ratshgupta-guptar76/blueprints/reports/summary.md

# Summary

```r
┏━━━━━━━━━━━━━━━━━━━━━━┳━━━━━━━━━━┳━━━━━━━━━━┳━━━━━━━━━━┳━━━━━━━━━━┳━━━━━━━━━━━┳━━━━━━━━━━┳━━━━━━━━━━━┳━━━━━━━━━━┳━━━━━━━━━━━┳━━━━━━━━━━┳━━━━━━━━━━━┳━━━━━━━━━━┓
┃                      ┃ Hold     ┃ Reg to   ┃          ┃          ┃ of which  ┃ Setup    ┃           ┃          ┃           ┃ of which ┃           ┃          ┃
┃                      ┃ Worst    ┃ Reg      ┃          ┃ Hold Vio ┃ reg to    ┃ Worst    ┃ Reg to    ┃ Setup    ┃ Setup Vio ┃ reg to   ┃ Max Cap   ┃ Max Slew ┃
┃ Corner/Group         ┃ Slack    ┃ Paths    ┃ Hold TNS ┃ Count    ┃ reg       ┃ Slack    ┃ Reg Paths ┃ TNS      ┃ Count     ┃ reg      ┃ Violatio… ┃ Violati… ┃
┡━━━━━━━━━━━━━━━━━━━━━━╇━━━━━━━━━━╇━━━━━━━━━━╇━━━━━━━━━━╇━━━━━━━━━━╇━━━━━━━━━━━╇━━━━━━━━━━╇━━━━━━━━━━━╇━━━━━━━━━━╇━━━━━━━━━━━╇━━━━━━━━━━╇━━━━━━━━━━━╇━━━━━━━━━━┩
│ Overall              │ 0.3302   │ 0.3302   │ 0.0000   │ 0        │ 0         │ 22.2979  │ 22.2979   │ 0.0000   │ 0         │ 0        │ 0         │ 0        │
│ nom_tt_025C_3v30     │ 0.4971   │ 0.4971   │ 0.0000   │ 0        │ 0         │ 26.9422  │ 26.9422   │ 0.0000   │ 0         │ 0        │ 0         │ 0        │
│ min_tt_025C_3v30     │ 0.4866   │ 0.4866   │ 0.0000   │ 0        │ 0         │ 27.0217  │ 27.0217   │ 0.0000   │ 0         │ 0        │ 0         │ 0        │
│ max_tt_025C_3v30     │ 0.5097   │ 0.5097   │ 0.0000   │ 0        │ 0         │ 26.8483  │ 26.8483   │ 0.0000   │ 0         │ 0        │ 0         │ 0        │
│ nom_ff_n40C_3v60     │ 0.3384   │ 0.3384   │ 0.0000   │ 0        │ 0         │ 28.7241  │ 29.7522   │ 0.0000   │ 0         │ 0        │ 0         │ 0        │
│ min_ff_n40C_3v60     │ 0.3302   │ 0.3302   │ 0.0000   │ 0        │ 0         │ 28.7914  │ 29.8150   │ 0.0000   │ 0         │ 0        │ 0         │ 0        │
│ max_ff_n40C_3v60     │ 0.3481   │ 0.3481   │ 0.0000   │ 0        │ 0         │ 28.6435  │ 29.6729   │ 0.0000   │ 0         │ 0        │ 0         │ 0        │
│ nom_ss_125C_3v00     │ 0.7416   │ 0.7416   │ 0.0000   │ 0        │ 0         │ 22.4203  │ 22.4203   │ 0.0000   │ 0         │ 0        │ 0         │ 0        │
│ min_ss_125C_3v00     │ 0.7283   │ 0.7283   │ 0.0000   │ 0        │ 0         │ 22.5227  │ 22.5227   │ 0.0000   │ 0         │ 0        │ 0         │ 0        │
│ max_ss_125C_3v00     │ 0.7576   │ 0.7576   │ 0.0000   │ 0        │ 0         │ 22.2979  │ 22.2979   │ 0.0000   │ 0         │ 0        │ 0         │ 0        │
└──────────────────────┴──────────┴──────────┴──────────┴──────────┴───────────┴──────────┴───────────┴──────────┴───────────┴──────────┴───────────┴──────────┘

```
