ratshgupta-guptar76/blueprints/docs/analog_sim/read_disturb_hi_qrbl.png

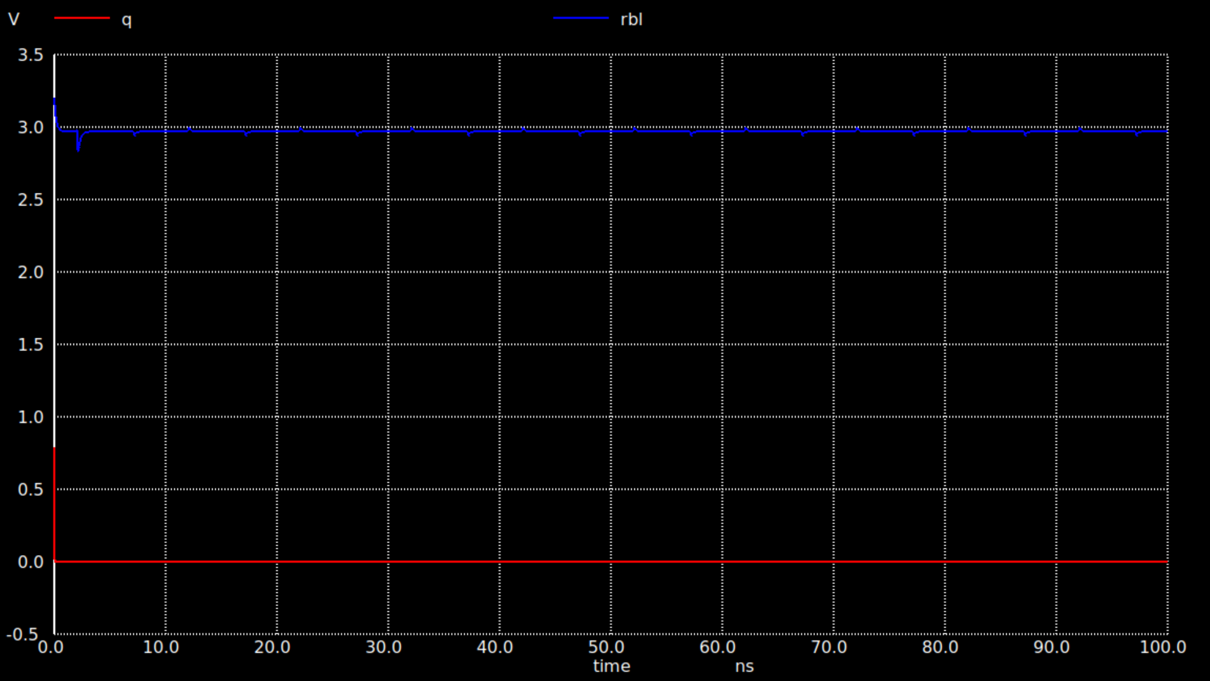
docs/analog_sim/read_disturb_hi_qrbl.png
