ratshgupta-guptar76/blueprints/docs/architecture/8T_03v3.png

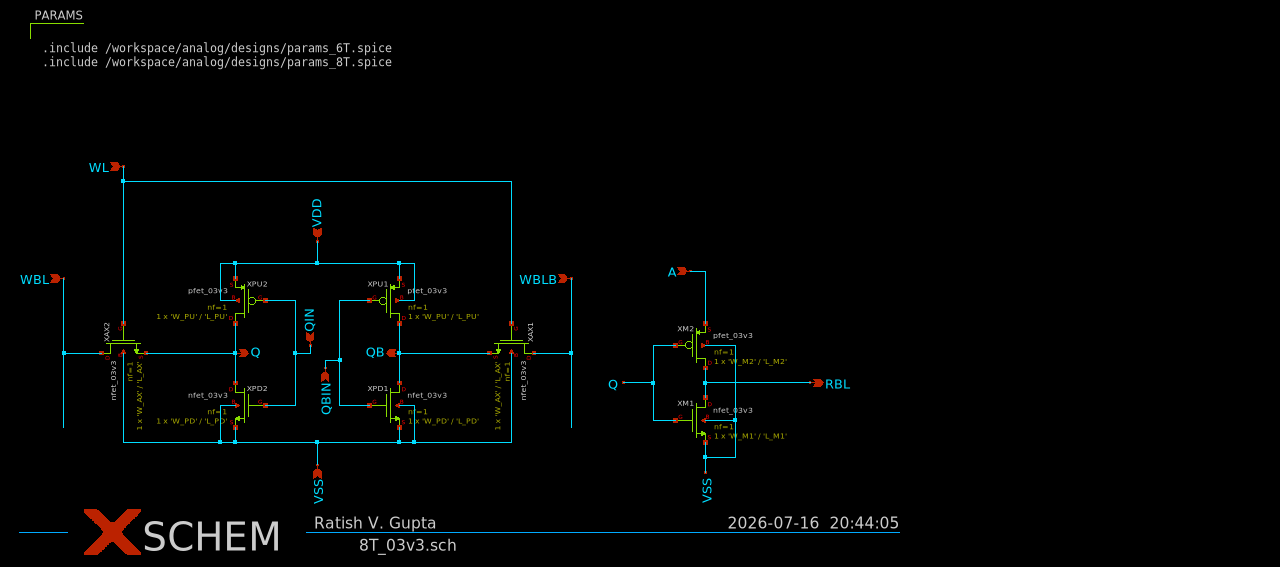
docs/architecture/8T_03v3.png
