ratshgupta-guptar76/blueprints/docs/architecture/ComputeFlow.png

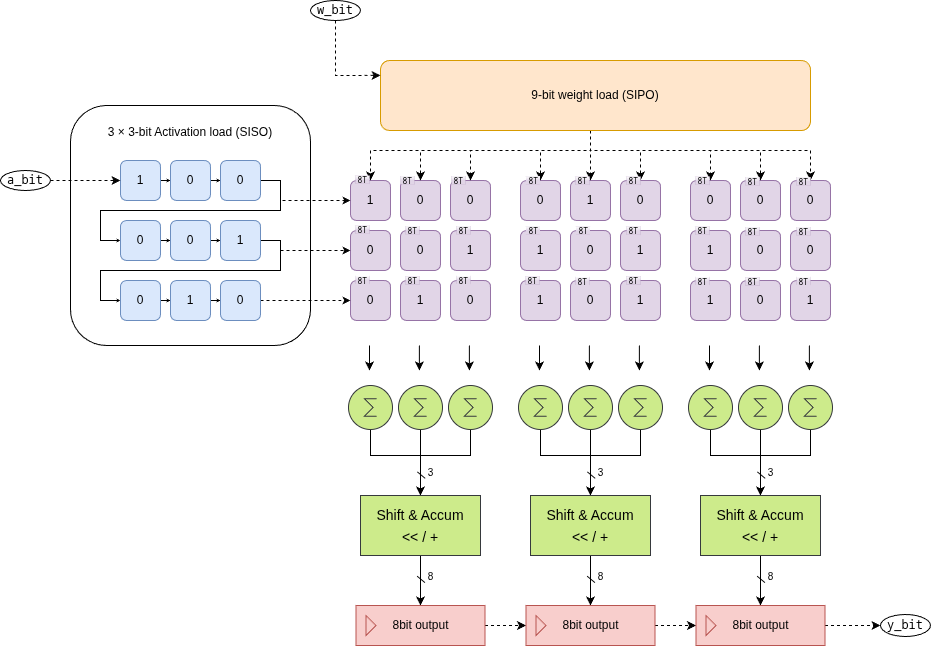
docs/architecture/ComputeFlow.png
