ratshgupta-guptar76/blueprints/docs/architecture/ComputeFlow_edited.png

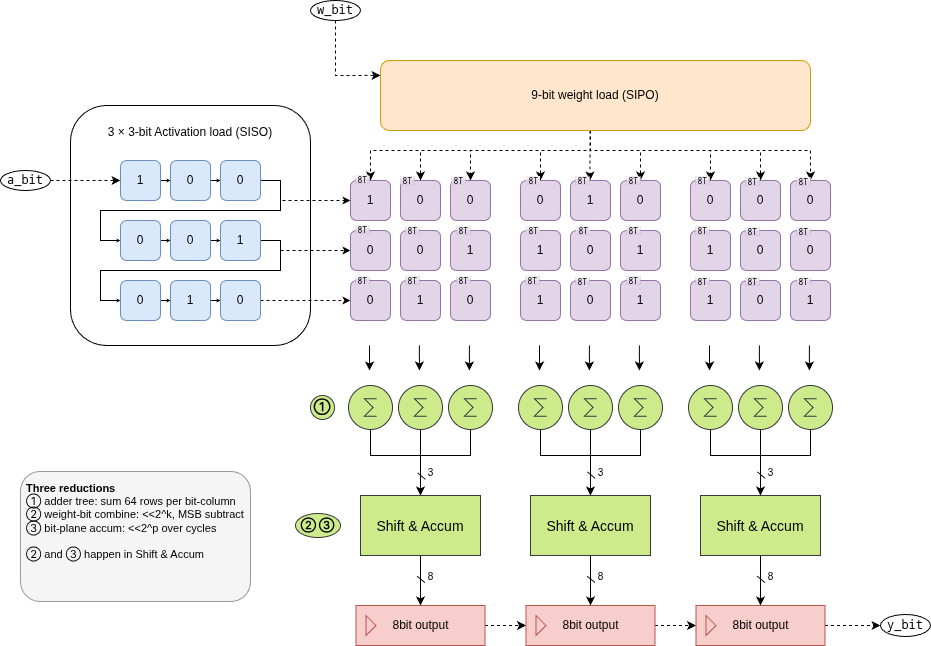
docs/architecture/ComputeFlow_edited.png
