ratshgupta-guptar76/blueprints/docs/architecture/fsm_states.png

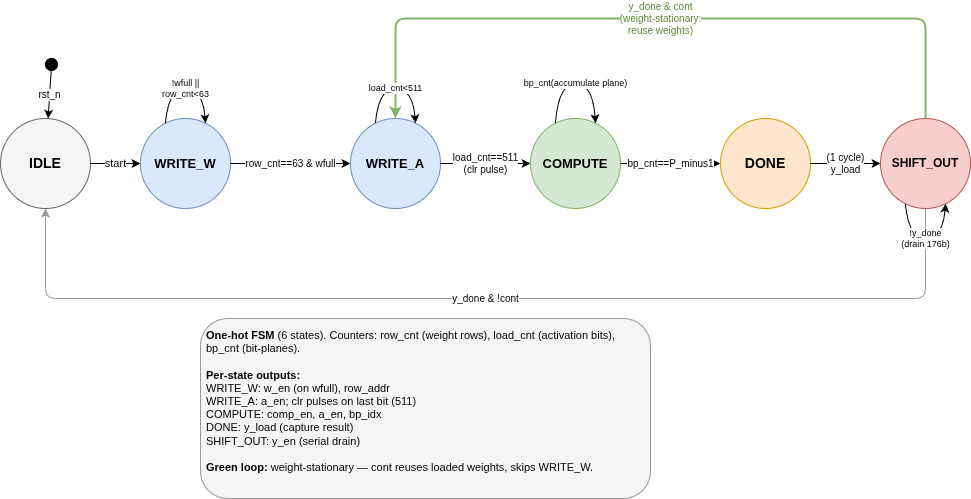
docs/architecture/fsm_states.png
