ratshgupta-guptar76/blueprints/docs/architecture/System_overview.png

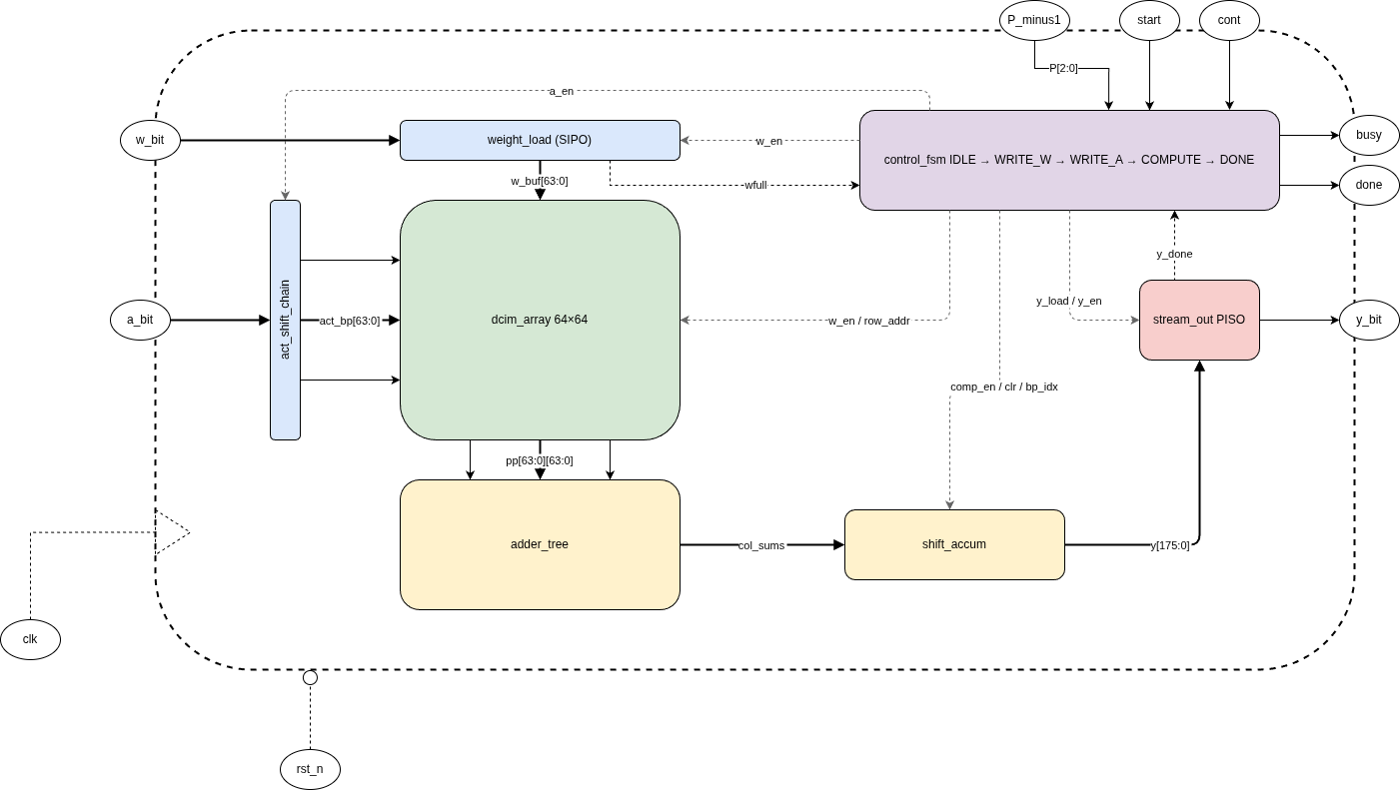
docs/architecture/System_overview.png
