ratshgupta-guptar76/blueprints/docs/architecture/SystemOverview2.png

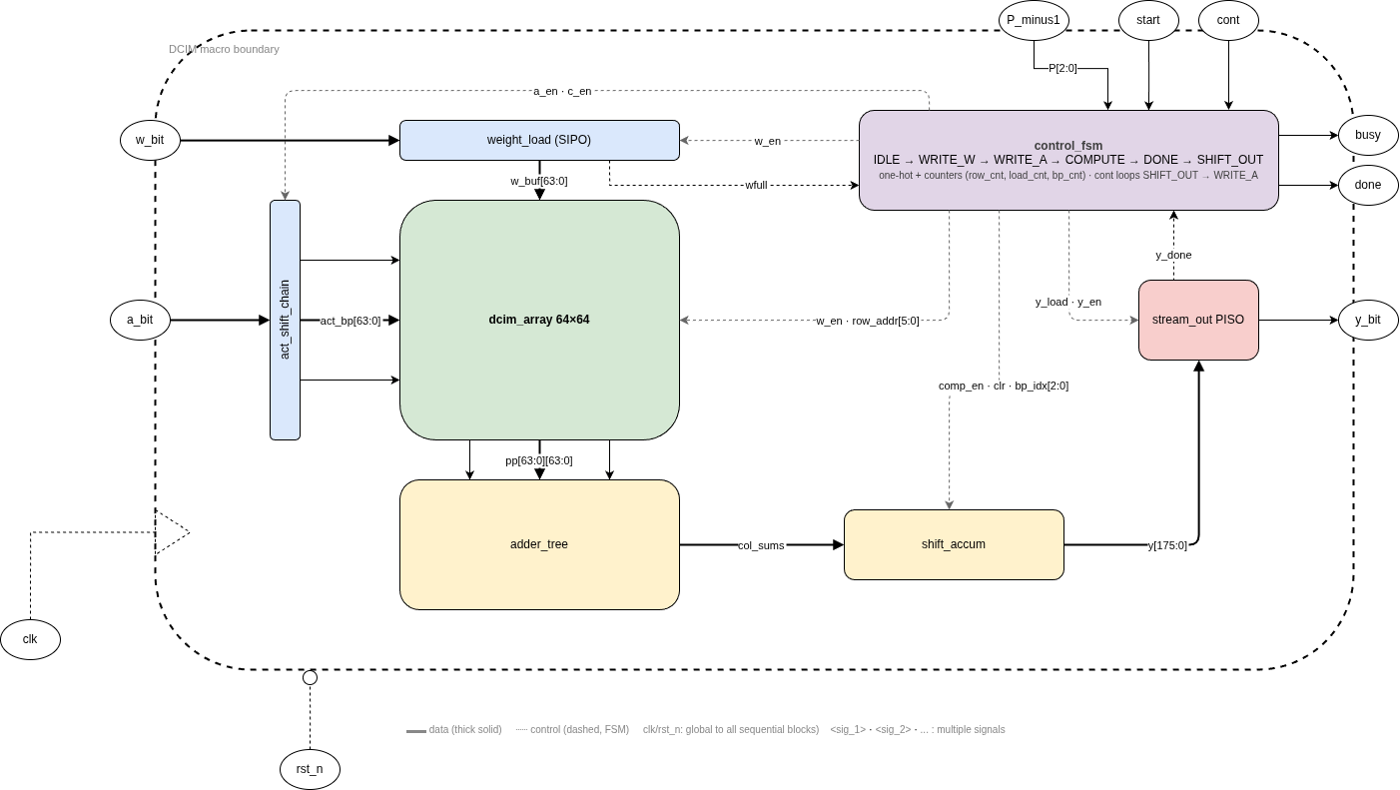
docs/architecture/SystemOverview2.png
