ratshgupta-guptar76/blueprints/reports/manufacturability.md

# Manufacturability Report

> rpt

```rst
* Antenna
Passed ✅

* LVS
Passed ✅

* DRC
Passed ✅

```
