ratshgupta-guptar76/blueprints/ip/sram_32x8_9T/lvs/sram_32x8_9T.lvs.spice

* NGSPICE file created from sram_32x8_9T.ext - technology: gf180mcuD

.subckt sram_32x8_9T RBL[0] RBL[1] RBL[2] RBL[3] RBL[4] RBL[5] RBL[6] RBL[7] RBL[8]
+ RBL[9] RBL[10] RBL[11] RBL[12] RBL[13] RBL[14] RBL[15] RBL[16] RBL[17] RBL[18] RBL[19]
+ RBL[20] RBL[21] RBL[22] RBL[23] RBL[24] RBL[25] RBL[26] RBL[27] RBL[28] RBL[29]
+ RBL[30] RBL[31] RBL[32] RBL[33] RBL[34] RBL[35] RBL[36] RBL[37] RBL[38] RBL[39]
+ RBL[40] RBL[41] RBL[42] RBL[43] RBL[44] RBL[45] RBL[46] RBL[47] RBL[48] RBL[49]
+ RBL[50] RBL[51] RBL[52] RBL[53] RBL[54] RBL[55] RBL[56] RBL[57] RBL[58] RBL[59]
+ RBL[60] RBL[61] RBL[62] RBL[63] RBL[64] RBL[65] RBL[66] RBL[67] RBL[68] RBL[69]
+ RBL[70] RBL[71] RBL[72] RBL[73] RBL[74] RBL[75] RBL[76] RBL[77] RBL[78] RBL[79]
+ RBL[80] RBL[81] RBL[82] RBL[83] RBL[84] RBL[85] RBL[86] RBL[87] RBL[88] RBL[89]
+ RBL[90] RBL[91] RBL[92] RBL[93] RBL[94] RBL[95] RBL[96] RBL[97] RBL[98] RBL[99]
+ RBL[100] RBL[101] RBL[102] RBL[103] RBL[104] RBL[105] RBL[106] RBL[107] RBL[108]
+ RBL[109] RBL[110] RBL[111] RBL[112] RBL[113] RBL[114] RBL[115] RBL[116] RBL[117]
+ RBL[118] RBL[119] RBL[120] RBL[121] RBL[122] RBL[123] RBL[124] RBL[125] RBL[126]
+ RBL[127] RBL[128] RBL[129] RBL[130] RBL[131] RBL[132] RBL[133] RBL[134] RBL[135]
+ RBL[136] RBL[137] RBL[138] RBL[139] RBL[140] RBL[141] RBL[142] RBL[143] RBL[144]
+ RBL[145] RBL[146] RBL[147] RBL[148] RBL[149] RBL[150] RBL[151] RBL[152] RBL[153]
+ RBL[154] RBL[155] RBL[156] RBL[157] RBL[158] RBL[159] RBL[160] RBL[161] RBL[162]
+ RBL[163] RBL[164] RBL[165] RBL[166] RBL[167] RBL[168] RBL[169] RBL[170] RBL[171]
+ RBL[172] RBL[173] RBL[174] RBL[175] RBL[176] RBL[177] RBL[178] RBL[179] RBL[180]
+ RBL[181] RBL[182] RBL[183] RBL[184] RBL[185] RBL[186] RBL[187] RBL[188] RBL[189]
+ RBL[190] RBL[191] RBL[192] RBL[193] RBL[194] RBL[195] RBL[196] RBL[197] RBL[198]
+ RBL[199] RBL[200] RBL[201] RBL[202] RBL[203] RBL[204] RBL[205] RBL[206] RBL[207]
+ RBL[208] RBL[209] RBL[210] RBL[211] RBL[212] RBL[213] RBL[214] RBL[215] RBL[216]
+ RBL[217] RBL[218] RBL[219] RBL[220] RBL[221] RBL[222] RBL[223] RBL[224] RBL[225]
+ RBL[226] RBL[227] RBL[228] RBL[229] RBL[230] RBL[231] RBL[232] RBL[233] RBL[234]
+ RBL[235] RBL[236] RBL[237] RBL[238] RBL[239] RBL[240] RBL[241] RBL[242] RBL[243]
+ RBL[244] RBL[245] RBL[246] RBL[247] RBL[248] RBL[249] RBL[250] RBL[251] RBL[252]
+ RBL[253] RBL[254] RBL[255] WBL[0] WBL[1] WBL[2] WBL[3] WBL[4] WBL[5] WBL[6] WBL[7]
+ WBLB[0] WBLB[1] WBLB[2] WBLB[3] WBLB[4] WBLB[5] WBLB[6] WBLB[7] WL[0] WL[1] WL[2]
+ WL[3] WL[4] WL[5] WL[6] WL[7] WL[8] WL[9] WL[10] WL[11] WL[12] WL[13] WL[14] WL[15]
+ WL[16] WL[17] WL[18] WL[19] WL[20] WL[21] WL[22] WL[23] WL[24] WL[25] WL[26] WL[27]
+ WL[28] WL[29] WL[30] WL[31] A[0] A[1] A[2] A[3] A[4] A[5] A[6] A[7] A[8] A[9] A[10]
+ A[11] A[12] A[13] A[14] A[15] A[16] A[17] A[18] A[19] A[20] A[21] A[22] A[23] A[24]
+ A[25] A[26] A[27] A[28] A[29] A[30] A[31] VSS VDD
X0 a_6452_1019# a_6421_513# VDD VDD pfet_03v3 ad=0.1936p pd=1.76u as=0.1496p ps=1.12u w=0.44u l=0.28u
X1 VDD a_6452_11979# a_6421_11473# VDD pfet_03v3 ad=0.1496p pd=1.12u as=0.1936p ps=1.76u w=0.44u l=0.28u
X2 VDD a_6452_13075# a_6421_12569# VDD pfet_03v3 ad=0.1496p pd=1.12u as=0.1936p ps=1.76u w=0.44u l=0.28u
X3 a_2720_1019# a_2689_513# VSS VSS nfet_03v3 ad=0.1397p pd=1.22u as=0.1108p ps=1.1u w=0.22u l=0.28u
X4 a_3964_8691# a_3933_8185# VDD VDD pfet_03v3 ad=0.1936p pd=1.76u as=0.1496p ps=1.12u w=0.44u l=0.28u
X5 a_3964_9787# a_3933_9281# VDD VDD pfet_03v3 ad=0.1936p pd=1.76u as=0.1496p ps=1.12u w=0.44u l=0.28u
X6 RBL[183] a_6421_24625# A[22] VDD pfet_03v3 ad=0.2082p pd=1.84u as=0.2024p ps=1.8u w=0.44u l=0.28u
X7 RBL[25] a_2689_3801# VSS VSS nfet_03v3 ad=0.1516p pd=1.64u as=0.1516p ps=1.64u w=0.22u l=0.28u
X8 VDD a_3964_15267# a_3933_14761# VDD pfet_03v3 ad=0.1496p pd=1.12u as=0.1936p ps=1.76u w=0.44u l=0.28u
X9 a_5799_1609# WL[1] WBLB[6] VSS nfet_03v3 ad=0.139p pd=1.215u as=0.2362p ps=2.03u w=0.32u l=0.28u
X10 a_4555_33393# WL[30] WBLB[4] VSS nfet_03v3 ad=0.139p pd=1.215u as=0.2362p ps=2.03u w=0.32u l=0.28u
X11 a_4555_32297# WL[29] WBLB[4] VSS nfet_03v3 ad=0.139p pd=1.215u as=0.2362p ps=2.03u w=0.32u l=0.28u
X12 a_3342_7595# WL[6] WBL[2] VSS nfet_03v3 ad=0.1397p pd=1.22u as=0.1706p ps=1.7u w=0.32u l=0.28u
X13 VDD a_4586_34995# a_4555_34489# VDD pfet_03v3 ad=0.1496p pd=1.12u as=0.1936p ps=1.76u w=0.44u l=0.28u
X14 VDD a_4586_33899# a_4555_33393# VDD pfet_03v3 ad=0.1496p pd=1.12u as=0.1936p ps=1.76u w=0.44u l=0.28u
X15 VSS a_4586_26227# a_4555_25721# VSS nfet_03v3 ad=0.1108p pd=1.1u as=0.139p ps=1.215u w=0.22u l=0.28u
X16 a_5830_19651# a_5799_19145# VSS VSS nfet_03v3 ad=0.1397p pd=1.22u as=0.1108p ps=1.1u w=0.22u l=0.28u
X17 a_5830_27323# a_5799_26817# VDD VDD pfet_03v3 ad=0.1936p pd=1.76u as=0.1496p ps=1.12u w=0.44u l=0.28u
X18 a_5830_18555# a_5799_18049# VSS VSS nfet_03v3 ad=0.1397p pd=1.22u as=0.1108p ps=1.1u w=0.22u l=0.28u
X19 a_5830_7595# a_5799_7089# VSS VSS nfet_03v3 ad=0.1397p pd=1.22u as=0.1108p ps=1.1u w=0.22u l=0.28u
X20 VDD a_5208_4307# a_5177_3801# VDD pfet_03v3 ad=0.1496p pd=1.12u as=0.1936p ps=1.76u w=0.44u l=0.28u
X21 a_2098_20747# WL[18] WBL[0] VSS nfet_03v3 ad=0.1397p pd=1.22u as=0.1706p ps=1.7u w=0.32u l=0.28u
X22 a_6452_30611# WL[27] WBL[7] VSS nfet_03v3 ad=0.1397p pd=1.22u as=0.1706p ps=1.7u w=0.32u l=0.28u
X23 VSS a_3342_15267# a_3311_14761# VSS nfet_03v3 ad=0.1108p pd=1.1u as=0.139p ps=1.215u w=0.22u l=0.28u
X24 RBL[187] a_3964_26227# A[23] VSS nfet_03v3 ad=0.1516p pd=1.64u as=0.1516p ps=1.64u w=0.22u l=0.28u
X25 RBL[179] a_3964_25131# A[22] VSS nfet_03v3 ad=0.1516p pd=1.64u as=0.1516p ps=1.64u w=0.22u l=0.28u
X26 VSS a_3964_9787# a_3933_9281# VSS nfet_03v3 ad=0.1108p pd=1.1u as=0.139p ps=1.215u w=0.22u l=0.28u
X27 RBL[53] a_5177_7089# VSS VSS nfet_03v3 ad=0.1516p pd=1.64u as=0.1516p ps=1.64u w=0.22u l=0.28u
X28 VSS a_5830_15267# a_5799_14761# VSS nfet_03v3 ad=0.1108p pd=1.1u as=0.139p ps=1.215u w=0.22u l=0.28u
X29 VSS a_6452_10883# a_6421_10377# VSS nfet_03v3 ad=0.1108p pd=1.1u as=0.139p ps=1.215u w=0.22u l=0.28u
X30 VSS a_6452_11979# a_6421_11473# VSS nfet_03v3 ad=0.1108p pd=1.1u as=0.139p ps=1.215u w=0.22u l=0.28u
X31 RBL[170] a_3311_23529# A[21] VDD pfet_03v3 ad=0.2082p pd=1.84u as=0.2024p ps=1.8u w=0.44u l=0.28u
X32 RBL[76] a_4555_10377# A[9] VDD pfet_03v3 ad=0.2082p pd=1.84u as=0.2024p ps=1.8u w=0.44u l=0.28u
X33 a_6452_29515# a_6421_29009# VDD VDD pfet_03v3 ad=0.1936p pd=1.76u as=0.1496p ps=1.12u w=0.44u l=0.28u
X34 a_6452_28419# a_6421_27913# VDD VDD pfet_03v3 ad=0.1936p pd=1.76u as=0.1496p ps=1.12u w=0.44u l=0.28u
X35 RBL[97] a_2720_14171# A[12] VSS nfet_03v3 ad=0.1516p pd=1.64u as=0.1516p ps=1.64u w=0.22u l=0.28u
X36 RBL[105] a_2720_15267# A[13] VSS nfet_03v3 ad=0.1516p pd=1.64u as=0.1516p ps=1.64u w=0.22u l=0.28u
X37 RBL[147] a_3933_20241# A[18] VDD pfet_03v3 ad=0.2082p pd=1.84u as=0.2024p ps=1.8u w=0.44u l=0.28u
X38 RBL[155] a_3933_21337# A[19] VDD pfet_03v3 ad=0.2082p pd=1.84u as=0.2024p ps=1.8u w=0.44u l=0.28u
X39 RBL[52] a_4555_7089# A[6] VDD pfet_03v3 ad=0.2082p pd=1.84u as=0.2024p ps=1.8u w=0.44u l=0.28u
X40 RBL[60] a_4555_8185# A[7] VDD pfet_03v3 ad=0.2082p pd=1.84u as=0.2024p ps=1.8u w=0.44u l=0.28u
X41 a_3964_8691# a_3933_8185# VSS VSS nfet_03v3 ad=0.1397p pd=1.22u as=0.1108p ps=1.1u w=0.22u l=0.28u
X42 a_6421_8185# WL[7] WBLB[7] VSS nfet_03v3 ad=0.139p pd=1.215u as=0.2362p ps=2.03u w=0.32u l=0.28u
X43 a_6421_9281# WL[8] WBLB[7] VSS nfet_03v3 ad=0.139p pd=1.215u as=0.2362p ps=2.03u w=0.32u l=0.28u
X44 RBL[88] a_2067_12569# A[11] VDD pfet_03v3 ad=0.2082p pd=1.84u as=0.2024p ps=1.8u w=0.44u l=0.28u
X45 RBL[238] a_5799_32297# A[29] VDD pfet_03v3 ad=0.2082p pd=1.84u as=0.2024p ps=1.8u w=0.44u l=0.28u
X46 RBL[230] a_5799_31201# A[28] VDD pfet_03v3 ad=0.2082p pd=1.84u as=0.2024p ps=1.8u w=0.44u l=0.28u
X47 a_2720_6499# WL[5] WBL[1] VSS nfet_03v3 ad=0.1397p pd=1.22u as=0.1706p ps=1.7u w=0.32u l=0.28u
X48 a_2720_5403# WL[4] WBL[1] VSS nfet_03v3 ad=0.1397p pd=1.22u as=0.1706p ps=1.7u w=0.32u l=0.28u
X49 RBL[78] a_5830_10883# A[9] VSS nfet_03v3 ad=0.1516p pd=1.64u as=0.1516p ps=1.64u w=0.22u l=0.28u
X50 RBL[86] a_5830_11979# A[10] VSS nfet_03v3 ad=0.1516p pd=1.64u as=0.1516p ps=1.64u w=0.22u l=0.28u
X51 a_3311_21337# WL[19] WBLB[2] VSS nfet_03v3 ad=0.139p pd=1.215u as=0.2362p ps=2.03u w=0.32u l=0.28u
X52 VSS a_5830_5403# a_5799_4897# VSS nfet_03v3 ad=0.1108p pd=1.1u as=0.139p ps=1.215u w=0.22u l=0.28u
X53 RBL[77] a_5177_10377# A[9] VDD pfet_03v3 ad=0.2082p pd=1.84u as=0.2024p ps=1.8u w=0.44u l=0.28u
X54 a_2720_33899# a_2689_33393# VSS VSS nfet_03v3 ad=0.1397p pd=1.22u as=0.1108p ps=1.1u w=0.22u l=0.28u
X55 a_2720_32803# a_2689_32297# VSS VSS nfet_03v3 ad=0.1397p pd=1.22u as=0.1108p ps=1.1u w=0.22u l=0.28u
X56 RBL[6] a_5830_1019# A[0] VSS nfet_03v3 ad=0.1516p pd=1.64u as=0.1516p ps=1.64u w=0.22u l=0.28u
X57 a_2720_9787# a_2689_9281# VSS VSS nfet_03v3 ad=0.1397p pd=1.22u as=0.1108p ps=1.1u w=0.22u l=0.28u
X58 a_3342_1019# a_3311_513# VDD VDD pfet_03v3 ad=0.1936p pd=1.76u as=0.1496p ps=1.12u w=0.44u l=0.28u
X59 RBL[247] a_6421_33393# A[30] VDD pfet_03v3 ad=0.2082p pd=1.84u as=0.2024p ps=1.8u w=0.44u l=0.28u
X60 VSS a_3342_29515# a_3311_29009# VSS nfet_03v3 ad=0.1108p pd=1.1u as=0.139p ps=1.215u w=0.22u l=0.28u
X61 a_4555_10377# WL[9] WBLB[4] VSS nfet_03v3 ad=0.139p pd=1.215u as=0.2362p ps=2.03u w=0.32u l=0.28u
X62 a_4555_11473# WL[10] WBLB[4] VSS nfet_03v3 ad=0.139p pd=1.215u as=0.2362p ps=2.03u w=0.32u l=0.28u
X63 RBL[137] a_2689_19145# VSS VSS nfet_03v3 ad=0.1516p pd=1.64u as=0.1516p ps=1.64u w=0.22u l=0.28u
X64 RBL[243] a_3964_33899# A[30] VSS nfet_03v3 ad=0.1516p pd=1.64u as=0.1516p ps=1.64u w=0.22u l=0.28u
X65 VDD a_4586_11979# a_4555_11473# VDD pfet_03v3 ad=0.1496p pd=1.12u as=0.1936p ps=1.76u w=0.44u l=0.28u
X66 VDD a_4586_13075# a_4555_12569# VDD pfet_03v3 ad=0.1496p pd=1.12u as=0.1936p ps=1.76u w=0.44u l=0.28u
X67 VDD a_3964_24035# a_3933_23529# VDD pfet_03v3 ad=0.1496p pd=1.12u as=0.1936p ps=1.76u w=0.44u l=0.28u
X68 a_3964_16363# a_3933_15857# VSS VSS nfet_03v3 ad=0.1397p pd=1.22u as=0.1108p ps=1.1u w=0.22u l=0.28u
X69 a_3964_17459# a_3933_16953# VSS VSS nfet_03v3 ad=0.1397p pd=1.22u as=0.1108p ps=1.1u w=0.22u l=0.28u
X70 VDD a_3964_22939# a_3933_22433# VDD pfet_03v3 ad=0.1496p pd=1.12u as=0.1936p ps=1.76u w=0.44u l=0.28u
X71 a_3964_26227# a_3933_25721# VDD VDD pfet_03v3 ad=0.1936p pd=1.76u as=0.1496p ps=1.12u w=0.44u l=0.28u
X72 VSS a_5830_29515# a_5799_29009# VSS nfet_03v3 ad=0.1108p pd=1.1u as=0.139p ps=1.215u w=0.22u l=0.28u
X73 RBL[118] a_5799_15857# VSS VSS nfet_03v3 ad=0.1516p pd=1.64u as=0.1516p ps=1.64u w=0.22u l=0.28u
X74 RBL[126] a_5799_16953# VSS VSS nfet_03v3 ad=0.1516p pd=1.64u as=0.1516p ps=1.64u w=0.22u l=0.28u
X75 RBL[180] a_4555_24625# A[22] VDD pfet_03v3 ad=0.2082p pd=1.84u as=0.2024p ps=1.8u w=0.44u l=0.28u
X76 VSS a_2098_9787# a_2067_9281# VSS nfet_03v3 ad=0.1108p pd=1.1u as=0.139p ps=1.215u w=0.22u l=0.28u
X77 a_5830_28419# a_5799_27913# VSS VSS nfet_03v3 ad=0.1397p pd=1.22u as=0.1108p ps=1.1u w=0.22u l=0.28u
X78 a_5830_27323# a_5799_26817# VSS VSS nfet_03v3 ad=0.1397p pd=1.22u as=0.1108p ps=1.1u w=0.22u l=0.28u
X79 RBL[50] a_3311_7089# VSS VSS nfet_03v3 ad=0.1516p pd=1.64u as=0.1516p ps=1.64u w=0.22u l=0.28u
X80 VSS a_5208_4307# a_5177_3801# VSS nfet_03v3 ad=0.1108p pd=1.1u as=0.139p ps=1.215u w=0.22u l=0.28u
X81 RBL[200] a_2067_27913# A[25] VDD pfet_03v3 ad=0.2082p pd=1.84u as=0.2024p ps=1.8u w=0.44u l=0.28u
X82 RBL[121] a_2689_16953# A[15] VDD pfet_03v3 ad=0.2082p pd=1.84u as=0.2024p ps=1.8u w=0.44u l=0.28u
X83 VDD a_2098_15267# a_2067_14761# VDD pfet_03v3 ad=0.1496p pd=1.12u as=0.1936p ps=1.76u w=0.44u l=0.28u
X84 a_2689_33393# WL[30] WBLB[1] VSS nfet_03v3 ad=0.139p pd=1.215u as=0.2362p ps=2.03u w=0.32u l=0.28u
X85 a_2689_32297# WL[29] WBLB[1] VSS nfet_03v3 ad=0.139p pd=1.215u as=0.2362p ps=2.03u w=0.32u l=0.28u
X86 a_2098_30611# WL[27] WBL[0] VSS nfet_03v3 ad=0.1397p pd=1.22u as=0.1706p ps=1.7u w=0.32u l=0.28u
X87 RBL[181] a_5177_24625# A[22] VDD pfet_03v3 ad=0.2082p pd=1.84u as=0.2024p ps=1.8u w=0.44u l=0.28u
X88 VDD a_3342_4307# a_3311_3801# VDD pfet_03v3 ad=0.1496p pd=1.12u as=0.1936p ps=1.76u w=0.44u l=0.28u
X89 a_2098_2115# a_2067_1609# VDD VDD pfet_03v3 ad=0.1936p pd=1.76u as=0.1496p ps=1.12u w=0.44u l=0.28u
X90 RBL[50] a_3342_7595# A[6] VSS nfet_03v3 ad=0.1516p pd=1.64u as=0.1516p ps=1.64u w=0.22u l=0.28u
X91 VSS a_5208_33899# a_5177_33393# VSS nfet_03v3 ad=0.1108p pd=1.1u as=0.139p ps=1.215u w=0.22u l=0.28u
X92 VSS a_5208_32803# a_5177_32297# VSS nfet_03v3 ad=0.1108p pd=1.1u as=0.139p ps=1.215u w=0.22u l=0.28u
X93 a_5208_28419# WL[25] WBL[5] VSS nfet_03v3 ad=0.1397p pd=1.22u as=0.1706p ps=1.7u w=0.32u l=0.28u
X94 a_5208_27323# WL[24] WBL[5] VSS nfet_03v3 ad=0.1397p pd=1.22u as=0.1706p ps=1.7u w=0.32u l=0.28u
X95 RBL[3] a_3964_1019# A[0] VSS nfet_03v3 ad=0.1516p pd=1.64u as=0.1516p ps=1.64u w=0.22u l=0.28u
X96 RBL[150] a_5830_20747# A[18] VSS nfet_03v3 ad=0.1516p pd=1.64u as=0.1516p ps=1.64u w=0.22u l=0.28u
X97 VSS a_4586_11979# a_4555_11473# VSS nfet_03v3 ad=0.1108p pd=1.1u as=0.139p ps=1.215u w=0.22u l=0.28u
X98 a_2720_20747# a_2689_20241# VDD VDD pfet_03v3 ad=0.1936p pd=1.76u as=0.1496p ps=1.12u w=0.44u l=0.28u
X99 VSS a_4586_10883# a_4555_10377# VSS nfet_03v3 ad=0.1108p pd=1.1u as=0.139p ps=1.215u w=0.22u l=0.28u
X100 VSS a_3964_21843# a_3933_21337# VSS nfet_03v3 ad=0.1108p pd=1.1u as=0.139p ps=1.215u w=0.22u l=0.28u
X101 VSS a_3964_22939# a_3933_22433# VSS nfet_03v3 ad=0.1108p pd=1.1u as=0.139p ps=1.215u w=0.22u l=0.28u
X102 VDD a_3964_31707# a_3933_31201# VDD pfet_03v3 ad=0.1496p pd=1.12u as=0.1936p ps=1.76u w=0.44u l=0.28u
X103 VDD a_3964_30611# a_3933_30105# VDD pfet_03v3 ad=0.1496p pd=1.12u as=0.1936p ps=1.76u w=0.44u l=0.28u
X104 a_4586_29515# a_4555_29009# VDD VDD pfet_03v3 ad=0.1936p pd=1.76u as=0.1496p ps=1.12u w=0.44u l=0.28u
X105 a_4586_28419# a_4555_27913# VDD VDD pfet_03v3 ad=0.1936p pd=1.76u as=0.1496p ps=1.12u w=0.44u l=0.28u
X106 VSS a_3342_1019# a_3311_513# VSS nfet_03v3 ad=0.1108p pd=1.1u as=0.139p ps=1.215u w=0.22u l=0.28u
X107 VDD a_2720_19651# a_2689_19145# VDD pfet_03v3 ad=0.1496p pd=1.12u as=0.1936p ps=1.76u w=0.44u l=0.28u
X108 RBL[53] a_5177_7089# A[6] VDD pfet_03v3 ad=0.2082p pd=1.84u as=0.2024p ps=1.8u w=0.44u l=0.28u
X109 RBL[61] a_5177_8185# A[7] VDD pfet_03v3 ad=0.2082p pd=1.84u as=0.2024p ps=1.8u w=0.44u l=0.28u
X110 VDD a_3342_16363# a_3311_15857# VDD pfet_03v3 ad=0.1496p pd=1.12u as=0.1936p ps=1.76u w=0.44u l=0.28u
X111 RBL[75] a_3964_10883# A[9] VSS nfet_03v3 ad=0.1516p pd=1.64u as=0.1516p ps=1.64u w=0.22u l=0.28u
X112 RBL[83] a_3964_11979# A[10] VSS nfet_03v3 ad=0.1516p pd=1.64u as=0.1516p ps=1.64u w=0.22u l=0.28u
X113 RBL[154] a_3342_21843# A[19] VSS nfet_03v3 ad=0.1516p pd=1.64u as=0.1516p ps=1.64u w=0.22u l=0.28u
X114 RBL[162] a_3342_22939# A[20] VSS nfet_03v3 ad=0.1516p pd=1.64u as=0.1516p ps=1.64u w=0.22u l=0.28u
X115 a_3933_34489# WL[31] WBLB[3] VSS nfet_03v3 ad=0.139p pd=1.215u as=0.2362p ps=2.03u w=0.32u l=0.28u
X116 RBL[74] a_3311_10377# A[9] VDD pfet_03v3 ad=0.2082p pd=1.84u as=0.2024p ps=1.8u w=0.44u l=0.28u
X117 VDD a_5830_16363# a_5799_15857# VDD pfet_03v3 ad=0.1496p pd=1.12u as=0.1936p ps=1.76u w=0.44u l=0.28u
X118 a_5208_29515# a_5177_29009# VDD VDD pfet_03v3 ad=0.1936p pd=1.76u as=0.1496p ps=1.12u w=0.44u l=0.28u
X119 a_5208_28419# a_5177_27913# VDD VDD pfet_03v3 ad=0.1936p pd=1.76u as=0.1496p ps=1.12u w=0.44u l=0.28u
X120 a_6421_29009# WL[26] WBLB[7] VSS nfet_03v3 ad=0.139p pd=1.215u as=0.2362p ps=2.03u w=0.32u l=0.28u
X121 a_5830_14171# a_5799_13665# VDD VDD pfet_03v3 ad=0.1936p pd=1.76u as=0.1496p ps=1.12u w=0.44u l=0.28u
X122 VSS a_6452_34995# a_6421_34489# VSS nfet_03v3 ad=0.1108p pd=1.1u as=0.139p ps=1.215u w=0.22u l=0.28u
X123 RBL[244] a_4555_33393# A[30] VDD pfet_03v3 ad=0.2082p pd=1.84u as=0.2024p ps=1.8u w=0.44u l=0.28u
X124 RBL[225] a_2720_31707# A[28] VSS nfet_03v3 ad=0.1516p pd=1.64u as=0.1516p ps=1.64u w=0.22u l=0.28u
X125 a_2098_7595# a_2067_7089# VSS VSS nfet_03v3 ad=0.1397p pd=1.22u as=0.1108p ps=1.1u w=0.22u l=0.28u
X126 a_4555_1609# WL[1] WBLB[4] VSS nfet_03v3 ad=0.139p pd=1.215u as=0.2362p ps=2.03u w=0.32u l=0.28u
X127 a_2689_11473# WL[10] WBLB[1] VSS nfet_03v3 ad=0.139p pd=1.215u as=0.2362p ps=2.03u w=0.32u l=0.28u
X128 a_2689_10377# WL[9] WBLB[1] VSS nfet_03v3 ad=0.139p pd=1.215u as=0.2362p ps=2.03u w=0.32u l=0.28u
X129 a_2067_21337# WL[19] WBLB[0] VSS nfet_03v3 ad=0.139p pd=1.215u as=0.2362p ps=2.03u w=0.32u l=0.28u
X130 VDD a_2098_24035# a_2067_23529# VDD pfet_03v3 ad=0.1496p pd=1.12u as=0.1936p ps=1.76u w=0.44u l=0.28u
X131 VDD a_2098_22939# a_2067_22433# VDD pfet_03v3 ad=0.1496p pd=1.12u as=0.1936p ps=1.76u w=0.44u l=0.28u
X132 a_2098_30611# a_2067_30105# VSS VSS nfet_03v3 ad=0.1397p pd=1.22u as=0.1108p ps=1.1u w=0.22u l=0.28u
X133 RBL[115] a_3933_15857# VSS VSS nfet_03v3 ad=0.1516p pd=1.64u as=0.1516p ps=1.64u w=0.22u l=0.28u
X134 RBL[123] a_3933_16953# VSS VSS nfet_03v3 ad=0.1516p pd=1.64u as=0.1516p ps=1.64u w=0.22u l=0.28u
X135 VSS a_3342_4307# a_3311_3801# VSS nfet_03v3 ad=0.1108p pd=1.1u as=0.139p ps=1.215u w=0.22u l=0.28u
X136 a_3964_3211# a_3933_2705# VDD VDD pfet_03v3 ad=0.1936p pd=1.76u as=0.1496p ps=1.12u w=0.44u l=0.28u
X137 RBL[245] a_5177_33393# A[30] VDD pfet_03v3 ad=0.2082p pd=1.84u as=0.2024p ps=1.8u w=0.44u l=0.28u
X138 RBL[61] a_5208_8691# A[7] VSS nfet_03v3 ad=0.1516p pd=1.64u as=0.1516p ps=1.64u w=0.22u l=0.28u
X139 RBL[69] a_5208_9787# A[8] VSS nfet_03v3 ad=0.1516p pd=1.64u as=0.1516p ps=1.64u w=0.22u l=0.28u
X140 VDD a_5208_20747# a_5177_20241# VDD pfet_03v3 ad=0.1496p pd=1.12u as=0.1936p ps=1.76u w=0.44u l=0.28u
X141 VDD a_2720_27323# a_2689_26817# VDD pfet_03v3 ad=0.1496p pd=1.12u as=0.1936p ps=1.76u w=0.44u l=0.28u
X142 VSS a_2720_18555# a_2689_18049# VSS nfet_03v3 ad=0.1108p pd=1.1u as=0.139p ps=1.215u w=0.22u l=0.28u
X143 VSS a_2720_19651# a_2689_19145# VSS nfet_03v3 ad=0.1108p pd=1.1u as=0.139p ps=1.215u w=0.22u l=0.28u
X144 RBL[4] a_4555_513# VSS VSS nfet_03v3 ad=0.1516p pd=1.64u as=0.1516p ps=1.64u w=0.22u l=0.28u
X145 a_3964_18555# a_3933_18049# VDD VDD pfet_03v3 ad=0.1936p pd=1.76u as=0.1496p ps=1.12u w=0.44u l=0.28u
X146 a_3964_17459# a_3933_16953# VDD VDD pfet_03v3 ad=0.1936p pd=1.76u as=0.1496p ps=1.12u w=0.44u l=0.28u
X147 RBL[50] a_3311_7089# A[6] VDD pfet_03v3 ad=0.2082p pd=1.84u as=0.2024p ps=1.8u w=0.44u l=0.28u
X148 RBL[58] a_3311_8185# A[7] VDD pfet_03v3 ad=0.2082p pd=1.84u as=0.2024p ps=1.8u w=0.44u l=0.28u
X149 RBL[178] a_3311_24625# A[22] VDD pfet_03v3 ad=0.2082p pd=1.84u as=0.2024p ps=1.8u w=0.44u l=0.28u
X150 a_5799_20241# WL[18] WBLB[6] VSS nfet_03v3 ad=0.139p pd=1.215u as=0.2362p ps=2.03u w=0.32u l=0.28u
X151 a_5177_9281# WL[8] WBLB[5] VSS nfet_03v3 ad=0.139p pd=1.215u as=0.2362p ps=2.03u w=0.32u l=0.28u
X152 a_5830_13075# a_5799_12569# VSS VSS nfet_03v3 ad=0.1397p pd=1.22u as=0.1108p ps=1.1u w=0.22u l=0.28u
X153 a_5830_14171# a_5799_13665# VSS VSS nfet_03v3 ad=0.1397p pd=1.22u as=0.1108p ps=1.1u w=0.22u l=0.28u
X154 a_5177_8185# WL[7] WBLB[5] VSS nfet_03v3 ad=0.139p pd=1.215u as=0.2362p ps=2.03u w=0.32u l=0.28u
X155 a_5830_3211# a_5799_2705# VSS VSS nfet_03v3 ad=0.1397p pd=1.22u as=0.1108p ps=1.1u w=0.22u l=0.28u
X156 a_4586_2115# WL[1] WBL[4] VSS nfet_03v3 ad=0.1397p pd=1.22u as=0.1706p ps=1.7u w=0.32u l=0.28u
X157 a_5830_2115# a_5799_1609# VSS VSS nfet_03v3 ad=0.1397p pd=1.22u as=0.1108p ps=1.1u w=0.22u l=0.28u
X158 a_3933_12569# WL[11] WBLB[3] VSS nfet_03v3 ad=0.139p pd=1.215u as=0.2362p ps=2.03u w=0.32u l=0.28u
X159 RBL[238] a_5799_32297# VSS VSS nfet_03v3 ad=0.1516p pd=1.64u as=0.1516p ps=1.64u w=0.22u l=0.28u
X160 RBL[215] a_6421_29009# VSS VSS nfet_03v3 ad=0.1516p pd=1.64u as=0.1516p ps=1.64u w=0.22u l=0.28u
X161 RBL[96] a_2067_13665# A[12] VDD pfet_03v3 ad=0.2082p pd=1.84u as=0.2024p ps=1.8u w=0.44u l=0.28u
X162 VDD a_3342_25131# a_3311_24625# VDD pfet_03v3 ad=0.1496p pd=1.12u as=0.1936p ps=1.76u w=0.44u l=0.28u
X163 VDD a_3964_1019# a_3933_513# VDD pfet_03v3 ad=0.1496p pd=1.12u as=0.1936p ps=1.76u w=0.44u l=0.28u
X164 RBL[147] a_3964_20747# A[18] VSS nfet_03v3 ad=0.1516p pd=1.64u as=0.1516p ps=1.64u w=0.22u l=0.28u
X165 RBL[218] a_3342_30611# A[27] VSS nfet_03v3 ad=0.1516p pd=1.64u as=0.1516p ps=1.64u w=0.22u l=0.28u
X166 RBL[133] a_5177_18049# VSS VSS nfet_03v3 ad=0.1516p pd=1.64u as=0.1516p ps=1.64u w=0.22u l=0.28u
X167 VDD a_2098_31707# a_2067_31201# VDD pfet_03v3 ad=0.1496p pd=1.12u as=0.1936p ps=1.76u w=0.44u l=0.28u
X168 VDD a_2098_30611# a_2067_30105# VDD pfet_03v3 ad=0.1496p pd=1.12u as=0.1936p ps=1.76u w=0.44u l=0.28u
X169 VSS a_2098_21843# a_2067_21337# VSS nfet_03v3 ad=0.1108p pd=1.1u as=0.139p ps=1.215u w=0.22u l=0.28u
X170 VSS a_2098_22939# a_2067_22433# VSS nfet_03v3 ad=0.1108p pd=1.1u as=0.139p ps=1.215u w=0.22u l=0.28u
X171 a_5830_34995# WL[31] WBL[6] VSS nfet_03v3 ad=0.1397p pd=1.22u as=0.1706p ps=1.7u w=0.32u l=0.28u
X172 VDD a_5830_25131# a_5799_24625# VDD pfet_03v3 ad=0.1496p pd=1.12u as=0.1936p ps=1.76u w=0.44u l=0.28u
X173 VSS a_5830_6499# a_5799_5993# VSS nfet_03v3 ad=0.1108p pd=1.1u as=0.139p ps=1.215u w=0.22u l=0.28u
X174 VDD a_6452_21843# a_6421_21337# VDD pfet_03v3 ad=0.1496p pd=1.12u as=0.1936p ps=1.76u w=0.44u l=0.28u
X175 a_2689_1609# WL[1] WBLB[1] VSS nfet_03v3 ad=0.139p pd=1.215u as=0.2362p ps=2.03u w=0.32u l=0.28u
X176 a_6452_15267# a_6421_14761# VSS VSS nfet_03v3 ad=0.1397p pd=1.22u as=0.1108p ps=1.1u w=0.22u l=0.28u
X177 a_3964_28419# WL[25] WBL[3] VSS nfet_03v3 ad=0.1397p pd=1.22u as=0.1706p ps=1.7u w=0.32u l=0.28u
X178 a_3964_27323# WL[24] WBL[3] VSS nfet_03v3 ad=0.1397p pd=1.22u as=0.1706p ps=1.7u w=0.32u l=0.28u
X179 a_5208_19651# WL[17] WBL[5] VSS nfet_03v3 ad=0.1397p pd=1.22u as=0.1706p ps=1.7u w=0.32u l=0.28u
X180 a_6421_3801# WL[3] WBLB[7] VSS nfet_03v3 ad=0.139p pd=1.215u as=0.2362p ps=2.03u w=0.32u l=0.28u
X181 a_6421_2705# WL[2] WBLB[7] VSS nfet_03v3 ad=0.139p pd=1.215u as=0.2362p ps=2.03u w=0.32u l=0.28u
X182 a_3342_29515# a_3311_29009# VDD VDD pfet_03v3 ad=0.1936p pd=1.76u as=0.1496p ps=1.12u w=0.44u l=0.28u
X183 a_3342_28419# a_3311_27913# VDD VDD pfet_03v3 ad=0.1936p pd=1.76u as=0.1496p ps=1.12u w=0.44u l=0.28u
X184 a_5208_8691# WL[7] WBL[5] VSS nfet_03v3 ad=0.1397p pd=1.22u as=0.1706p ps=1.7u w=0.32u l=0.28u
X185 a_5208_9787# WL[8] WBL[5] VSS nfet_03v3 ad=0.1397p pd=1.22u as=0.1706p ps=1.7u w=0.32u l=0.28u
X186 VSS a_4586_34995# a_4555_34489# VSS nfet_03v3 ad=0.1108p pd=1.1u as=0.139p ps=1.215u w=0.22u l=0.28u
X187 a_4586_29515# WL[26] WBL[4] VSS nfet_03v3 ad=0.1397p pd=1.22u as=0.1706p ps=1.7u w=0.32u l=0.28u
X188 RBL[62] a_5799_8185# VSS VSS nfet_03v3 ad=0.1516p pd=1.64u as=0.1516p ps=1.64u w=0.22u l=0.28u
X189 RBL[70] a_5799_9281# VSS VSS nfet_03v3 ad=0.1516p pd=1.64u as=0.1516p ps=1.64u w=0.22u l=0.28u
X190 VSS a_2720_28419# a_2689_27913# VSS nfet_03v3 ad=0.1108p pd=1.1u as=0.139p ps=1.215u w=0.22u l=0.28u
X191 VSS a_2720_27323# a_2689_26817# VSS nfet_03v3 ad=0.1108p pd=1.1u as=0.139p ps=1.215u w=0.22u l=0.28u
X192 a_3964_1019# a_3933_513# VDD VDD pfet_03v3 ad=0.1936p pd=1.76u as=0.1496p ps=1.12u w=0.44u l=0.28u
X193 VSS a_3342_25131# a_3311_24625# VSS nfet_03v3 ad=0.1108p pd=1.1u as=0.139p ps=1.215u w=0.22u l=0.28u
X194 VSS a_3342_24035# a_3311_23529# VSS nfet_03v3 ad=0.1108p pd=1.1u as=0.139p ps=1.215u w=0.22u l=0.28u
X195 RBL[15] a_6421_1609# VSS VSS nfet_03v3 ad=0.1516p pd=1.64u as=0.1516p ps=1.64u w=0.22u l=0.28u
X196 VDD a_3342_32803# a_3311_32297# VDD pfet_03v3 ad=0.1496p pd=1.12u as=0.1936p ps=1.76u w=0.44u l=0.28u
X197 a_5177_29009# WL[26] WBLB[5] VSS nfet_03v3 ad=0.139p pd=1.215u as=0.2362p ps=2.03u w=0.32u l=0.28u
X198 VSS a_5830_25131# a_5799_24625# VSS nfet_03v3 ad=0.1108p pd=1.1u as=0.139p ps=1.215u w=0.22u l=0.28u
X199 VSS a_5830_24035# a_5799_23529# VSS nfet_03v3 ad=0.1108p pd=1.1u as=0.139p ps=1.215u w=0.22u l=0.28u
X200 VDD a_5830_32803# a_5799_32297# VDD pfet_03v3 ad=0.1496p pd=1.12u as=0.1936p ps=1.76u w=0.44u l=0.28u
X201 VSS a_6452_20747# a_6421_20241# VSS nfet_03v3 ad=0.1108p pd=1.1u as=0.139p ps=1.215u w=0.22u l=0.28u
X202 RBL[242] a_3311_33393# A[30] VDD pfet_03v3 ad=0.2082p pd=1.84u as=0.2024p ps=1.8u w=0.44u l=0.28u
X203 a_6452_29515# a_6421_29009# VSS VSS nfet_03v3 ad=0.1397p pd=1.22u as=0.1108p ps=1.1u w=0.22u l=0.28u
X204 RBL[169] a_2720_24035# A[21] VSS nfet_03v3 ad=0.1516p pd=1.64u as=0.1516p ps=1.64u w=0.22u l=0.28u
X205 a_2720_16363# WL[14] WBL[1] VSS nfet_03v3 ad=0.1397p pd=1.22u as=0.1706p ps=1.7u w=0.32u l=0.28u
X206 a_2720_17459# WL[15] WBL[1] VSS nfet_03v3 ad=0.1397p pd=1.22u as=0.1706p ps=1.7u w=0.32u l=0.28u
X207 RBL[219] a_3933_30105# A[27] VDD pfet_03v3 ad=0.2082p pd=1.84u as=0.2024p ps=1.8u w=0.44u l=0.28u
X208 RBL[81] a_2689_11473# A[10] VDD pfet_03v3 ad=0.2082p pd=1.84u as=0.2024p ps=1.8u w=0.44u l=0.28u
X209 RBL[160] a_2067_22433# A[20] VDD pfet_03v3 ad=0.2082p pd=1.84u as=0.2024p ps=1.8u w=0.44u l=0.28u
X210 RBL[133] a_5208_18555# A[16] VSS nfet_03v3 ad=0.1516p pd=1.64u as=0.1516p ps=1.64u w=0.22u l=0.28u
X211 a_5799_30105# WL[27] WBLB[6] VSS nfet_03v3 ad=0.139p pd=1.215u as=0.2362p ps=2.03u w=0.32u l=0.28u
X212 a_5830_13075# WL[11] WBL[6] VSS nfet_03v3 ad=0.1397p pd=1.22u as=0.1706p ps=1.7u w=0.32u l=0.28u
X213 RBL[15] a_6452_2115# A[1] VSS nfet_03v3 ad=0.1516p pd=1.64u as=0.1516p ps=1.64u w=0.22u l=0.28u
X214 RBL[235] a_3933_32297# VSS VSS nfet_03v3 ad=0.1516p pd=1.64u as=0.1516p ps=1.64u w=0.22u l=0.28u
X215 RBL[130] a_3311_18049# VSS VSS nfet_03v3 ad=0.1516p pd=1.64u as=0.1516p ps=1.64u w=0.22u l=0.28u
X216 a_4555_20241# WL[18] WBLB[4] VSS nfet_03v3 ad=0.139p pd=1.215u as=0.2362p ps=2.03u w=0.32u l=0.28u
X217 RBL[209] a_2689_29009# VSS VSS nfet_03v3 ad=0.1516p pd=1.64u as=0.1516p ps=1.64u w=0.22u l=0.28u
X218 RBL[59] a_3933_8185# VSS VSS nfet_03v3 ad=0.1516p pd=1.64u as=0.1516p ps=1.64u w=0.22u l=0.28u
X219 RBL[67] a_3933_9281# VSS VSS nfet_03v3 ad=0.1516p pd=1.64u as=0.1516p ps=1.64u w=0.22u l=0.28u
X220 a_4586_15267# a_4555_14761# VSS VSS nfet_03v3 ad=0.1397p pd=1.22u as=0.1108p ps=1.1u w=0.22u l=0.28u
X221 VDD a_4586_21843# a_4555_21337# VDD pfet_03v3 ad=0.1496p pd=1.12u as=0.1936p ps=1.76u w=0.44u l=0.28u
X222 a_3964_34995# a_3933_34489# VDD VDD pfet_03v3 ad=0.1936p pd=1.76u as=0.1496p ps=1.12u w=0.44u l=0.28u
X223 a_3964_26227# a_3933_25721# VSS VSS nfet_03v3 ad=0.1397p pd=1.22u as=0.1108p ps=1.1u w=0.22u l=0.28u
X224 a_3964_33899# a_3933_33393# VDD VDD pfet_03v3 ad=0.1936p pd=1.76u as=0.1496p ps=1.12u w=0.44u l=0.28u
X225 a_5830_15267# a_5799_14761# VDD VDD pfet_03v3 ad=0.1936p pd=1.76u as=0.1496p ps=1.12u w=0.44u l=0.28u
X226 VDD a_2720_14171# a_2689_13665# VDD pfet_03v3 ad=0.1496p pd=1.12u as=0.1936p ps=1.76u w=0.44u l=0.28u
X227 RBL[103] a_6421_13665# VSS VSS nfet_03v3 ad=0.1516p pd=1.64u as=0.1516p ps=1.64u w=0.22u l=0.28u
X228 RBL[111] a_6421_14761# VSS VSS nfet_03v3 ad=0.1516p pd=1.64u as=0.1516p ps=1.64u w=0.22u l=0.28u
X229 RBL[190] a_5799_25721# VSS VSS nfet_03v3 ad=0.1516p pd=1.64u as=0.1516p ps=1.64u w=0.22u l=0.28u
X230 RBL[182] a_5799_24625# VSS VSS nfet_03v3 ad=0.1516p pd=1.64u as=0.1516p ps=1.64u w=0.22u l=0.28u
X231 a_6452_18555# WL[16] WBL[7] VSS nfet_03v3 ad=0.1397p pd=1.22u as=0.1706p ps=1.7u w=0.32u l=0.28u
X232 a_2720_24035# WL[21] WBL[1] VSS nfet_03v3 ad=0.1397p pd=1.22u as=0.1706p ps=1.7u w=0.32u l=0.28u
X233 VDD a_3342_10883# a_3311_10377# VDD pfet_03v3 ad=0.1496p pd=1.12u as=0.1936p ps=1.76u w=0.44u l=0.28u
X234 RBL[193] a_2689_26817# A[24] VDD pfet_03v3 ad=0.2082p pd=1.84u as=0.2024p ps=1.8u w=0.44u l=0.28u
X235 RBL[185] a_2689_25721# A[23] VDD pfet_03v3 ad=0.2082p pd=1.84u as=0.2024p ps=1.8u w=0.44u l=0.28u
X236 VDD a_3964_5403# a_3933_4897# VDD pfet_03v3 ad=0.1496p pd=1.12u as=0.1936p ps=1.76u w=0.44u l=0.28u
X237 RBL[23] a_6421_2705# A[2] VDD pfet_03v3 ad=0.2082p pd=1.84u as=0.2024p ps=1.8u w=0.44u l=0.28u
X238 RBL[15] a_6421_1609# A[1] VDD pfet_03v3 ad=0.2082p pd=1.84u as=0.2024p ps=1.8u w=0.44u l=0.28u
X239 VDD a_5830_10883# a_5799_10377# VDD pfet_03v3 ad=0.1496p pd=1.12u as=0.1936p ps=1.76u w=0.44u l=0.28u
X240 a_5208_15267# a_5177_14761# VSS VSS nfet_03v3 ad=0.1397p pd=1.22u as=0.1108p ps=1.1u w=0.22u l=0.28u
X241 a_6452_16363# a_6421_15857# VDD VDD pfet_03v3 ad=0.1936p pd=1.76u as=0.1496p ps=1.12u w=0.44u l=0.28u
X242 a_3964_19651# WL[17] WBL[3] VSS nfet_03v3 ad=0.1397p pd=1.22u as=0.1706p ps=1.7u w=0.32u l=0.28u
X243 a_3964_4307# a_3933_3801# VDD VDD pfet_03v3 ad=0.1936p pd=1.76u as=0.1496p ps=1.12u w=0.44u l=0.28u
X244 RBL[12] a_4586_2115# A[1] VSS nfet_03v3 ad=0.1516p pd=1.64u as=0.1516p ps=1.64u w=0.22u l=0.28u
X245 a_2098_3211# a_2067_2705# VSS VSS nfet_03v3 ad=0.1397p pd=1.22u as=0.1108p ps=1.1u w=0.22u l=0.28u
X246 a_2098_2115# a_2067_1609# VSS VSS nfet_03v3 ad=0.1397p pd=1.22u as=0.1108p ps=1.1u w=0.22u l=0.28u
X247 VDD a_2720_6499# a_2689_5993# VDD pfet_03v3 ad=0.1496p pd=1.12u as=0.1936p ps=1.76u w=0.44u l=0.28u
X248 VDD a_2720_7595# a_2689_7089# VDD pfet_03v3 ad=0.1496p pd=1.12u as=0.1936p ps=1.76u w=0.44u l=0.28u
X249 a_3342_29515# WL[26] WBL[2] VSS nfet_03v3 ad=0.1397p pd=1.22u as=0.1706p ps=1.7u w=0.32u l=0.28u
X250 VDD a_6452_8691# a_6421_8185# VDD pfet_03v3 ad=0.1496p pd=1.12u as=0.1936p ps=1.76u w=0.44u l=0.28u
X251 VDD a_6452_9787# a_6421_9281# VDD pfet_03v3 ad=0.1496p pd=1.12u as=0.1936p ps=1.76u w=0.44u l=0.28u
X252 RBL[70] a_5799_9281# A[8] VDD pfet_03v3 ad=0.2082p pd=1.84u as=0.2024p ps=1.8u w=0.44u l=0.28u
X253 a_3342_2115# WL[1] WBL[2] VSS nfet_03v3 ad=0.1397p pd=1.22u as=0.1706p ps=1.7u w=0.32u l=0.28u
X254 VSS a_4586_20747# a_4555_20241# VSS nfet_03v3 ad=0.1108p pd=1.1u as=0.139p ps=1.215u w=0.22u l=0.28u
X255 VSS a_3964_31707# a_3933_31201# VSS nfet_03v3 ad=0.1108p pd=1.1u as=0.139p ps=1.215u w=0.22u l=0.28u
X256 a_4586_29515# a_4555_29009# VSS VSS nfet_03v3 ad=0.1397p pd=1.22u as=0.1108p ps=1.1u w=0.22u l=0.28u
X257 a_2720_5403# a_2689_4897# VDD VDD pfet_03v3 ad=0.1936p pd=1.76u as=0.1496p ps=1.12u w=0.44u l=0.28u
X258 RBL[246] a_5799_33393# VSS VSS nfet_03v3 ad=0.1516p pd=1.64u as=0.1516p ps=1.64u w=0.22u l=0.28u
X259 VSS a_2720_13075# a_2689_12569# VSS nfet_03v3 ad=0.1108p pd=1.1u as=0.139p ps=1.215u w=0.22u l=0.28u
X260 VSS a_2720_14171# a_2689_13665# VSS nfet_03v3 ad=0.1108p pd=1.1u as=0.139p ps=1.215u w=0.22u l=0.28u
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
