ratshgupta-guptar76/blueprints/def/A07/project_defs/A/A07_A_padring.v

module A07_A_padring (
    N01,
    N02,
    N03,
    N04,
    N05,
    N06,
    N07,
    N08,
    N09,
    N10,
    N11,
    N12,
    N13,
    N14,
    N15,
    N16,
    N17,
    N18,
    N19,
    N20,
    N21,
    N22,
    E01,
    E02,
    E03,
    E04,
    E05,
    E06,
    E07,
    E08,
    E09,
    E10,
    E11,
    E12,
    E13,
    E14,
    E15,
    E16,
    E17,
    E18,
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
    W13_PU,
    W13_PD,
    W13_Y,
    W14_PU,
    W14_PD,
    W14_Y,
    W15_PU,
    W15_PD,
    W15_Y,
    W16_PU,
    W16_PD,
    W16_Y,
    W17_PU,
    W17_PD,
    W17_Y,
    W18_PU,
    W18_PD,
    W18_Y,
    W19_PU,
    W19_PD,
    W19_Y,
    W20_PU,
    W20_PD,
    W20_Y,
    W21_PU,
    W21_PD,
    W21_Y,
    W22_CS,
    W22_SL,
    W22_IE,
    W22_OE,
    W22_PU,
    W22_PD,
    W22_A,
    W22_PDRV0,
    W22_PDRV1,
    W22_Y,
    N01_CS,
    N01_SL,
    N01_IE,
    N01_OE,
    N01_PU,
    N01_PD,
    N01_A,
    N01_PDRV0,
    N01_PDRV1,
    N01_Y,
    N02_CS,
    N02_SL,
    N02_IE,
    N02_OE,
    N02_PU,
    N02_PD,
    N02_A,
    N02_PDRV0,
    N02_PDRV1,
    N02_Y
);
  inout N01;
  inout N02;
  inout N03;
  inout N04;
  inout N05;
  inout N06;
  inout N07;
  inout N08;
  inout N09;
  inout N10;
  inout N11;
  inout N12;
  inout N13;
  inout N14;
  inout N15;
  inout N16;
  inout N17;
  inout N18;
  inout N19;
  inout N20;
  inout N21;
  inout N22;
  inout E01;
  inout E02;
  inout E03;
  inout E04;
  inout E05;
  inout E06;
  inout E07;
  inout E08;
  inout E09;
  inout E10;
  inout E11;
  inout E12;
  inout E13;
  inout E14;
  inout E15;
  inout E16;
  inout E17;
  inout E18;
  inout E19;
  inout E20;
  inout E21;
  inout E22;
  inout S01;
  inout S02;
  inout S03;
  inout S04;
  inout S05;
  inout S06;
  inout S07;
  inout S08;
  inout S09;
  inout S10;
  inout S11;
  inout S12;
  inout S13;
  inout S14;
  inout S15;
  inout S16;
  inout S17;
  inout S18;
  inout S19;
  inout S20;
  inout S21;
  inout S22;
  inout W01;
  inout W02;
  inout W03;
  inout W04;
  inout W05;
  inout W06;
  inout W07;
  inout W08;
  inout W09;
  inout W10;
  inout W11;
  inout W12;
  inout W13;
  inout W14;
  inout W15;
  inout W16;
  inout W17;
  inout W18;
  inout W19;
  inout W20;
  inout W21;
  inout W22;
  input W13_PU;
  input W13_PD;
  output W13_Y;
  input W14_PU;
  input W14_PD;
  output W14_Y;
  input W15_PU;
  input W15_PD;
  output W15_Y;
  input W16_PU;
  input W16_PD;
  output W16_Y;
  input W17_PU;
  input W17_PD;
  output W17_Y;
  input W18_PU;
  input W18_PD;
  output W18_Y;
  input W19_PU;
  input W19_PD;
  output W19_Y;
  input W20_PU;
  input W20_PD;
  output W20_Y;
  input W21_PU;
  input W21_PD;
  output W21_Y;
  input W22_CS;
  input W22_SL;
  input W22_IE;
  input W22_OE;
  input W22_PU;
  input W22_PD;
  input W22_A;
  input W22_PDRV0;
  input W22_PDRV1;
  output W22_Y;
  input N01_CS;
  input N01_SL;
  input N01_IE;
  input N01_OE;
  input N01_PU;
  input N01_PD;
  input N01_A;
  input N01_PDRV0;
  input N01_PDRV1;
  output N01_Y;
  input N02_CS;
  input N02_SL;
  input N02_IE;
  input N02_OE;
  input N02_PU;
  input N02_PD;
  input N02_A;
  input N02_PDRV0;
  input N02_PDRV1;
  output N02_Y;
  wire FLOAT_VDD_1;


  gf180mcu_fd_io__bi_t N01 (.CS(N01_CS), .SL(N01_SL), .IE(N01_IE), .OE(N01_OE), .PU(N01_PU), .PD(N01_PD), .A(N01_A), .PDRV0(N01_PDRV0), .PDRV1(N01_PDRV1), .Y(N01_Y), .PAD(N01), .VSS(W12), .DVSS(W12), .VDD(N03), .DVDD(N03));
  gf180mcu_fd_io__bi_t N02 (.CS(N02_CS), .SL(N02_SL), .IE(N02_IE), .OE(N02_OE), .PU(N02_PU), .PD(N02_PD), .A(N02_A), .PDRV0(N02_PDRV0), .PDRV1(N02_PDRV1), .Y(N02_Y), .PAD(N02), .VSS(W12), .DVSS(W12), .VDD(N03), .DVDD(N03));
  gf180mcu_fd_io__dvdd N03 (.DVDD(N03), .VSS(W12), .DVSS(W12));
  gf180mcu_fd_io__asig_5p0 N04 (.ASIG5V(N04), .VSS(W12), .DVSS(W12), .VDD(FLOAT_VDD_1), .DVDD(FLOAT_VDD_1));
  gf180mcu_fd_io__asig_5p0 N05 (.ASIG5V(N05), .VSS(W12), .DVSS(W12), .VDD(FLOAT_VDD_1), .DVDD(FLOAT_VDD_1));
  gf180mcu_fd_io__asig_5p0 N06 (.ASIG5V(N06), .VSS(W12), .DVSS(W12), .VDD(FLOAT_VDD_1), .DVDD(FLOAT_VDD_1));
  gf180mcu_fd_io__asig_5p0 N07 (.ASIG5V(N07), .VSS(W12), .DVSS(W12), .VDD(FLOAT_VDD_1), .DVDD(FLOAT_VDD_1));
  gf180mcu_fd_io__asig_5p0 N08 (.ASIG5V(N08), .VSS(W12), .DVSS(W12), .VDD(FLOAT_VDD_1), .DVDD(FLOAT_VDD_1));
  gf180mcu_fd_io__asig_5p0 N09 (.ASIG5V(N09), .VSS(W12), .DVSS(W12), .VDD(FLOAT_VDD_1), .DVDD(FLOAT_VDD_1));
  gf180mcu_fd_io__asig_5p0 N10 (.ASIG5V(N10), .VSS(W12), .DVSS(W12), .VDD(FLOAT_VDD_1), .DVDD(FLOAT_VDD_1));
  gf180mcu_fd_io__asig_5p0 N11 (.ASIG5V(N11), .VSS(W12), .DVSS(W12), .VDD(FLOAT_VDD_1), .DVDD(FLOAT_VDD_1));
  gf180mcu_fd_io__asig_5p0 N12 (.ASIG5V(N12), .VSS(W12), .DVSS(W12), .VDD(FLOAT_VDD_1), .DVDD(FLOAT_VDD_1));
  gf180mcu_fd_io__asig_5p0 N13 (.ASIG5V(N13), .VSS(W12), .DVSS(W12), .VDD(FLOAT_VDD_1), .DVDD(FLOAT_VDD_1));
  gf180mcu_fd_io__asig_5p0 N14 (.ASIG5V(N14), .VSS(W12), .DVSS(W12), .VDD(FLOAT_VDD_1), .DVDD(FLOAT_VDD_1));
  gf180mcu_fd_io__asig_5p0 N15 (.ASIG5V(N15), .VSS(W12), .DVSS(W12), .VDD(FLOAT_VDD_1), .DVDD(FLOAT_VDD_1));
  gf180mcu_fd_io__asig_5p0 N16 (.ASIG5V(N16), .VSS(W12), .DVSS(W12), .VDD(FLOAT_VDD_1), .DVDD(FLOAT_VDD_1));
  gf180mcu_fd_io__asig_5p0 N17 (.ASIG5V(N17), .VSS(W12), .DVSS(W12), .VDD(FLOAT_VDD_1), .DVDD(FLOAT_VDD_1));
  gf180mcu_fd_io__asig_5p0 N18 (.ASIG5V(N18), .VSS(W12), .DVSS(W12), .VDD(FLOAT_VDD_1), .DVDD(FLOAT_VDD_1));
  gf180mcu_fd_io__asig_5p0 N19 (.ASIG5V(N19), .VSS(W12), .DVSS(W12), .VDD(FLOAT_VDD_1), .DVDD(FLOAT_VDD_1));
  gf180mcu_fd_io__asig_5p0 N20 (.ASIG5V(N20), .VSS(W12), .DVSS(W12), .VDD(FLOAT_VDD_1), .DVDD(FLOAT_VDD_1));
  gf180mcu_fd_io__asig_5p0 N21 (.ASIG5V(N21), .VSS(W12), .DVSS(W12), .VDD(FLOAT_VDD_1), .DVDD(FLOAT_VDD_1));
  gf180mcu_fd_io__asig_5p0 N22 (.ASIG5V(N22), .VSS(W12), .DVSS(W12), .VDD(FLOAT_VDD_1), .DVDD(FLOAT_VDD_1));
  gf180mcu_fd_io__asig_5p0 S01 (.ASIG5V(S01), .VSS(W12), .DVSS(W12), .VDD(FLOAT_VDD_1), .DVDD(FLOAT_VDD_1));
  gf180mcu_fd_io__asig_5p0 S02 (.ASIG5V(S02), .VSS(W12), .DVSS(W12), .VDD(FLOAT_VDD_1), .DVDD(FLOAT_VDD_1));
  gf180mcu_fd_io__asig_5p0 S03 (.ASIG5V(S03), .VSS(W12), .DVSS(W12), .VDD(FLOAT_VDD_1), .DVDD(FLOAT_VDD_1));
  gf180mcu_fd_io__asig_5p0 S04 (.ASIG5V(S04), .VSS(W12), .DVSS(W12), .VDD(FLOAT_VDD_1), .DVDD(FLOAT_VDD_1));
  gf180mcu_fd_io__asig_5p0 S05 (.ASIG5V(S05), .VSS(W12), .DVSS(W12), .VDD(FLOAT_VDD_1), .DVDD(FLOAT_VDD_1));
  gf180mcu_fd_io__asig_5p0 S06 (.ASIG5V(S06), .VSS(W12), .DVSS(W12), .VDD(FLOAT_VDD_1), .DVDD(FLOAT_VDD_1));
  gf180mcu_fd_io__asig_5p0 S07 (.ASIG5V(S07), .VSS(W12), .DVSS(W12), .VDD(FLOAT_VDD_1), .DVDD(FLOAT_VDD_1));
  gf180mcu_fd_io__asig_5p0 S08 (.ASIG5V(S08), .VSS(W12), .DVSS(W12), .VDD(FLOAT_VDD_1), .DVDD(FLOAT_VDD_1));
  gf180mcu_fd_io__asig_5p0 S09 (.ASIG5V(S09), .VSS(W12), .DVSS(W12), .VDD(FLOAT_VDD_1), .DVDD(FLOAT_VDD_1));
  gf180mcu_fd_io__asig_5p0 S10 (.ASIG5V(S10), .VSS(W12), .DVSS(W12), .VDD(FLOAT_VDD_1), .DVDD(FLOAT_VDD_1));
  gf180mcu_fd_io__asig_5p0 S11 (.ASIG5V(S11), .VSS(W12), .DVSS(W12), .VDD(FLOAT_VDD_1), .DVDD(FLOAT_VDD_1));
  gf180mcu_fd_io__asig_5p0 S12 (.ASIG5V(S12), .VSS(W12), .DVSS(W12), .VDD(FLOAT_VDD_1), .DVDD(FLOAT_VDD_1));
  gf180mcu_fd_io__asig_5p0 S13 (.ASIG5V(S13), .VSS(W12), .DVSS(W12), .VDD(FLOAT_VDD_1), .DVDD(FLOAT_VDD_1));
  gf180mcu_fd_io__asig_5p0 S14 (.ASIG5V(S14), .VSS(W12), .DVSS(W12), .VDD(FLOAT_VDD_1), .DVDD(FLOAT_VDD_1));
  gf180mcu_fd_io__asig_5p0 S15 (.ASIG5V(S15), .VSS(W12), .DVSS(W12), .VDD(FLOAT_VDD_1), .DVDD(FLOAT_VDD_1));
  gf180mcu_fd_io__asig_5p0 S16 (.ASIG5V(S16), .VSS(W12), .DVSS(W12), .VDD(FLOAT_VDD_1), .DVDD(FLOAT_VDD_1));
  gf180mcu_fd_io__asig_5p0 S17 (.ASIG5V(S17), .VSS(W12), .DVSS(W12), .VDD(FLOAT_VDD_1), .DVDD(FLOAT_VDD_1));
  gf180mcu_fd_io__asig_5p0 S18 (.ASIG5V(S18), .VSS(W12), .DVSS(W12), .VDD(FLOAT_VDD_1), .DVDD(FLOAT_VDD_1));
  gf180mcu_fd_io__asig_5p0 S19 (.ASIG5V(S19), .VSS(W12), .DVSS(W12), .VDD(FLOAT_VDD_1), .DVDD(FLOAT_VDD_1));
  gf180mcu_fd_io__asig_5p0 S20 (.ASIG5V(S20), .VSS(W12), .DVSS(W12), .VDD(FLOAT_VDD_1), .DVDD(FLOAT_VDD_1));
  gf180mcu_fd_io__asig_5p0 S21 (.ASIG5V(S21), .VSS(W12), .DVSS(W12), .VDD(FLOAT_VDD_1), .DVDD(FLOAT_VDD_1));
  gf180mcu_fd_io__asig_5p0 S22 (.ASIG5V(S22), .VSS(W12), .DVSS(W12), .VDD(FLOAT_VDD_1), .DVDD(FLOAT_VDD_1));
  gf180mcu_fd_io__asig_5p0 W01 (.ASIG5V(W01), .VSS(W12), .DVSS(W12), .VDD(FLOAT_VDD_1), .DVDD(FLOAT_VDD_1));
  gf180mcu_fd_io__asig_5p0 W02 (.ASIG5V(W02), .VSS(W12), .DVSS(W12), .VDD(FLOAT_VDD_1), .DVDD(FLOAT_VDD_1));
  gf180mcu_fd_io__asig_5p0 W03 (.ASIG5V(W03), .VSS(W12), .DVSS(W12), .VDD(FLOAT_VDD_1), .DVDD(FLOAT_VDD_1));
  gf180mcu_fd_io__asig_5p0 W04 (.ASIG5V(W04), .VSS(W12), .DVSS(W12), .VDD(FLOAT_VDD_1), .DVDD(FLOAT_VDD_1));
  gf180mcu_fd_io__asig_5p0 W05 (.ASIG5V(W05), .VSS(W12), .DVSS(W12), .VDD(FLOAT_VDD_1), .DVDD(FLOAT_VDD_1));
  gf180mcu_fd_io__asig_5p0 W06 (.ASIG5V(W06), .VSS(W12), .DVSS(W12), .VDD(FLOAT_VDD_1), .DVDD(FLOAT_VDD_1));
  gf180mcu_fd_io__asig_5p0 W07 (.ASIG5V(W07), .VSS(W12), .DVSS(W12), .VDD(FLOAT_VDD_1), .DVDD(FLOAT_VDD_1));
  gf180mcu_fd_io__asig_5p0 W08 (.ASIG5V(W08), .VSS(W12), .DVSS(W12), .VDD(FLOAT_VDD_1), .DVDD(FLOAT_VDD_1));
  gf180mcu_fd_io__asig_5p0 W09 (.ASIG5V(W09), .VSS(W12), .DVSS(W12), .VDD(FLOAT_VDD_1), .DVDD(FLOAT_VDD_1));
  gf180mcu_fd_io__asig_5p0 W10 (.ASIG5V(W10), .VSS(W12), .DVSS(W12), .VDD(FLOAT_VDD_1), .DVDD(FLOAT_VDD_1));
  gf180mcu_fd_io__asig_5p0 W11 (.ASIG5V(W11), .VSS(W12), .DVSS(W12), .VDD(FLOAT_VDD_1), .DVDD(FLOAT_VDD_1));
  gf180mcu_fd_io__dvss W12 (.DVSS(W12), .VDD(N03), .DVDD(N03));
  gf180mcu_fd_io__in_s W13 (.PU(W13_PU), .PD(W13_PD), .Y(W13_Y), .PAD(W13), .VSS(W12), .DVSS(W12), .VDD(N03), .DVDD(N03));
  gf180mcu_fd_io__in_c W14 (.PU(W14_PU), .PD(W14_PD), .Y(W14_Y), .PAD(W14), .VSS(W12), .DVSS(W12), .VDD(N03), .DVDD(N03));
  gf180mcu_fd_io__in_c W15 (.PU(W15_PU), .PD(W15_PD), .Y(W15_Y), .PAD(W15), .VSS(W12), .DVSS(W12), .VDD(N03), .DVDD(N03));
  gf180mcu_fd_io__in_c W16 (.PU(W16_PU), .PD(W16_PD), .Y(W16_Y), .PAD(W16), .VSS(W12), .DVSS(W12), .VDD(N03), .DVDD(N03));
  gf180mcu_fd_io__in_c W17 (.PU(W17_PU), .PD(W17_PD), .Y(W17_Y), .PAD(W17), .VSS(W12), .DVSS(W12), .VDD(N03), .DVDD(N03));
  gf180mcu_fd_io__in_c W18 (.PU(W18_PU), .PD(W18_PD), .Y(W18_Y), .PAD(W18), .VSS(W12), .DVSS(W12), .VDD(N03), .DVDD(N03));
  gf180mcu_fd_io__in_c W19 (.PU(W19_PU), .PD(W19_PD), .Y(W19_Y), .PAD(W19), .VSS(W12), .DVSS(W12), .VDD(N03), .DVDD(N03));
  gf180mcu_fd_io__in_c W20 (.PU(W20_PU), .PD(W20_PD), .Y(W20_Y), .PAD(W20), .VSS(W12), .DVSS(W12), .VDD(N03), .DVDD(N03));
  gf180mcu_fd_io__in_c W21 (.PU(W21_PU), .PD(W21_PD), .Y(W21_Y), .PAD(W21), .VSS(W12), .DVSS(W12), .VDD(N03), .DVDD(N03));
  gf180mcu_fd_io__bi_t W22 (.CS(W22_CS), .SL(W22_SL), .IE(W22_IE), .OE(W22_OE), .PU(W22_PU), .PD(W22_PD), .A(W22_A), .PDRV0(W22_PDRV0), .PDRV1(W22_PDRV1), .Y(W22_Y), .PAD(W22), .VSS(W12), .DVSS(W12), .VDD(N03), .DVDD(N03));
  gf180mcu_fd_io__asig_5p0 E01 (.ASIG5V(E01), .VSS(W12), .DVSS(W12), .VDD(FLOAT_VDD_1), .DVDD(FLOAT_VDD_1));
  gf180mcu_fd_io__asig_5p0 E02 (.ASIG5V(E02), .VSS(W12), .DVSS(W12), .VDD(FLOAT_VDD_1), .DVDD(FLOAT_VDD_1));
  gf180mcu_fd_io__asig_5p0 E03 (.ASIG5V(E03), .VSS(W12), .DVSS(W12), .VDD(FLOAT_VDD_1), .DVDD(FLOAT_VDD_1));
  gf180mcu_fd_io__asig_5p0 E04 (.ASIG5V(E04), .VSS(W12), .DVSS(W12), .VDD(FLOAT_VDD_1), .DVDD(FLOAT_VDD_1));
  gf180mcu_fd_io__asig_5p0 E05 (.ASIG5V(E05), .VSS(W12), .DVSS(W12), .VDD(FLOAT_VDD_1), .DVDD(FLOAT_VDD_1));
  gf180mcu_fd_io__asig_5p0 E06 (.ASIG5V(E06), .VSS(W12), .DVSS(W12), .VDD(FLOAT_VDD_1), .DVDD(FLOAT_VDD_1));
  gf180mcu_fd_io__asig_5p0 E07 (.ASIG5V(E07), .VSS(W12), .DVSS(W12), .VDD(FLOAT_VDD_1), .DVDD(FLOAT_VDD_1));
  gf180mcu_fd_io__asig_5p0 E08 (.ASIG5V(E08), .VSS(W12), .DVSS(W12), .VDD(FLOAT_VDD_1), .DVDD(FLOAT_VDD_1));
  gf180mcu_fd_io__asig_5p0 E09 (.ASIG5V(E09), .VSS(W12), .DVSS(W12), .VDD(FLOAT_VDD_1), .DVDD(FLOAT_VDD_1));
  gf180mcu_fd_io__asig_5p0 E10 (.ASIG5V(E10), .VSS(W12), .DVSS(W12), .VDD(FLOAT_VDD_1), .DVDD(FLOAT_VDD_1));
  gf180mcu_fd_io__asig_5p0 E11 (.ASIG5V(E11), .VSS(W12), .DVSS(W12), .VDD(FLOAT_VDD_1), .DVDD(FLOAT_VDD_1));
  gf180mcu_fd_io__asig_5p0 E12 (.ASIG5V(E12), .VSS(W12), .DVSS(W12), .VDD(FLOAT_VDD_1), .DVDD(FLOAT_VDD_1));
  gf180mcu_fd_io__asig_5p0 E13 (.ASIG5V(E13), .VSS(W12), .DVSS(W12), .VDD(FLOAT_VDD_1), .DVDD(FLOAT_VDD_1));
  gf180mcu_fd_io__asig_5p0 E14 (.ASIG5V(E14), .VSS(W12), .DVSS(W12), .VDD(FLOAT_VDD_1), .DVDD(FLOAT_VDD_1));
  gf180mcu_fd_io__asig_5p0 E15 (.ASIG5V(E15), .VSS(W12), .DVSS(W12), .VDD(FLOAT_VDD_1), .DVDD(FLOAT_VDD_1));
  gf180mcu_fd_io__asig_5p0 E16 (.ASIG5V(E16), .VSS(W12), .DVSS(W12), .VDD(FLOAT_VDD_1), .DVDD(FLOAT_VDD_1));
  gf180mcu_fd_io__asig_5p0 E17 (.ASIG5V(E17), .VSS(W12), .DVSS(W12), .VDD(FLOAT_VDD_1), .DVDD(FLOAT_VDD_1));
  gf180mcu_fd_io__asig_5p0 E18 (.ASIG5V(E18), .VSS(W12), .DVSS(W12), .VDD(FLOAT_VDD_1), .DVDD(FLOAT_VDD_1));
  gf180mcu_fd_io__asig_5p0 E19 (.ASIG5V(E19), .VSS(W12), .DVSS(W12), .VDD(FLOAT_VDD_1), .DVDD(FLOAT_VDD_1));
  gf180mcu_fd_io__asig_5p0 E20 (.ASIG5V(E20), .VSS(W12), .DVSS(W12), .VDD(FLOAT_VDD_1), .DVDD(FLOAT_VDD_1));
  gf180mcu_fd_io__asig_5p0 E21 (.ASIG5V(E21), .VSS(W12), .DVSS(W12), .VDD(FLOAT_VDD_1), .DVDD(FLOAT_VDD_1));
  gf180mcu_fd_io__asig_5p0 E22 (.ASIG5V(E22), .VSS(W12), .DVSS(W12), .VDD(FLOAT_VDD_1), .DVDD(FLOAT_VDD_1));
  gf180mcu_fd_io__cor CORNER_4 (.VSS(W12), .DVSS(W12), .VDD(N03), .DVDD(N03));
  gf180mcu_fd_io__cor CORNER_3 (.VSS(W12), .DVSS(W12), .VDD(FLOAT_VDD_1), .DVDD(FLOAT_VDD_1));
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
  gf180mcu_fd_io__fill5 FILL_E20_3 (.VSS(W12), .DVSS(W12), .VDD(FLOAT_VDD_1), .DVDD(FLOAT_VDD_1));
  gf180mcu_fd_io__fill5 FILL_E20_4 (.VSS(W12), .DVSS(W12), .VDD(FLOAT_VDD_1), .DVDD(FLOAT_VDD_1));
  gf180mcu_fd_io__fill5 FILL_E20_5 (.VSS(W12), .DVSS(W12), .VDD(FLOAT_VDD_1), .DVDD(FLOAT_VDD_1));
  gf180mcu_fd_io__fill5 FILL_E21_1 (.VSS(W12), .DVSS(W12), .VDD(FLOAT_VDD_1), .DVDD(FLOAT_VDD_1));
  gf180mcu_fd_io__fill5 FILL_E21_2 (.VSS(W12), .DVSS(W12), .VDD(FLOAT_VDD_1), .DVDD(FLOAT_VDD_1));
  gf180mcu_fd_io__fill5 FILL_E21_3 (.VSS(W12), .DVSS(W12), .VDD(FLOAT_VDD_1), .DVDD(FLOAT_VDD_1));
  gf180mcu_fd_io__fill5 FILL_E21_4 (.VSS(W12), .DVSS(W12), .VDD(FLOAT_VDD_1), .DVDD(FLOAT_VDD_1));
  gf180mcu_fd_io__fill5 FILL_E21_5 (.VSS(W12), .DVSS(W12), .VDD(FLOAT_VDD_1), .DVDD(FLOAT_VDD_1));
  gf180mcu_fd_io__fill5 FILL_E22_1 (.VSS(W12), .DVSS(W12), .VDD(FLOAT_VDD_1), .DVDD(FLOAT_VDD_1));
  gf180mcu_fd_io__fill5 FILL_E22_2 (.VSS(W12), .DVSS(W12), .VDD(FLOAT_VDD_1), .DVDD(FLOAT_VDD_1));
  gf180mcu_fd_io__fill5 FILL_E22_3 (.VSS(W12), .DVSS(W12), .VDD(FLOAT_VDD_1), .DVDD(FLOAT_VDD_1));
  gf180mcu_fd_io__fill5 FILL_E22_4 (.VSS(W12), .DVSS(W12), .VDD(FLOAT_VDD_1), .DVDD(FLOAT_VDD_1));
  gf180mcu_fd_io__fill5 FILL_E22_5 (.VSS(W12), .DVSS(W12), .VDD(FLOAT_VDD_1), .DVDD(FLOAT_VDD_1));
endmodule
