ratshgupta-guptar76/blueprints/src/dcim_array.sv

// ==================================================================================
// dcim_array.sv — weight storage + AND grid (dumb datapath, no FSM)
// ==================================================================================
// Stores the weight matrix; outputs 1-bit partial products (weight AND activation)
// for the current bit-plane. Obeys w_en; FSM drives timing.
//
//   w_mem [ROWS][COLS] : 4096 behavioral flops -> 8T SRAM macro at PnR. No reset
//                        (SRAM powers up X). Write all rows before any read.
//   write port         : row_decoder -> one-hot wl; selected row latches w_buf.
//                        wl=0 when w_en=0 (no stray writes).
//   pp (combinational) : pp[i] = w_mem[i] & {COLS{act_bp[i]}}. Transient product,
//                        not storage. ACTIVE-HIGH — no ~ here (column inverter is
//                        added at the macro swap, not in RTL).
//   col layout         : column c = bit (c%DW) of weight (c/DW). Must match
//                        weight_load + golden_model.
//
// TEST:
//   - Write a known row via row_addr/w_buf, read it back -> w_mem latches correct row only.
//   - wl is one-hot under w_en; w_en=0 -> no write (assert $onehot0(wl)).
//   - pp[i] == w_mem[i] & act_bp[i] broadcast, for a few hand-picked planes.
//   - Column mapping matches golden_model layout (one weight, check its 8 columns).
//   - pp is active-high (no inversion vs golden products).
// ==================================================================================
`timescale 1ns / 1ps

module dcim_array #(
    parameter int ROWS = dcim_pkg::ROWS,
    parameter int COLS = dcim_pkg::COLS
) (
    input logic                    w_en,
    input logic [$clog2(ROWS)-1:0] row_addr,
    input logic [COLS-1:0]         w_buf,
    input logic [ROWS-1:0]         act_bp,

    output logic [ROWS-1:0][COLS-1:0] pp
);

    logic [ROWS-1:0] wl;
    row_decoder #(
        .ROWS (ROWS),
        .RW   ($clog2(ROWS))
    ) ROW_DECODER (
        .en   (w_en),
        .addr (row_addr),
        .wl   (wl)
    );


    logic [255:0] rbl [3:0];  

    sram_32x8_9T u_sram_32x8_9T_0 (
        .WL   (wl),
        .A    (act_bp),
        .WBL  ( w_buf[7:0]),
        .WBLB (~w_buf[7:0]),
        .RBL  (rbl[0])
    );

    sram_32x8_9T u_sram_32x8_9T_1 (
        .WL   (wl),
        .A    (act_bp),
        .WBL  ( w_buf[15:8]),
        .WBLB (~w_buf[15:8]),
        .RBL  (rbl[1])
    );

    sram_32x8_9T u_sram_32x8_9T_2 (
        .WL   (wl),
        .A    (act_bp),
        .WBL  ( w_buf[23:16]),
        .WBLB (~w_buf[23:16]),
        .RBL  (rbl[2])
    );

    sram_32x8_9T u_sram_32x8_9T_3 (
        .WL   (wl),
        .A    (act_bp),
        .WBL  ( w_buf[31:24]),
        .WBLB (~w_buf[31:24]),
        .RBL  (rbl[3])
    );
    genvar w, r, c;
    generate
        for (w = 0; w < 4; w++) begin : WMAP
            for (r = 0; r < ROWS; r++) begin : RMAP
                for (c = 0; c < 8; c++) begin : CMAP
                    assign pp[r][w*8 + c] = rbl[w][r*8 + c];
                end
            end
        end
    endgenerate

endmodule
