ratshgupta-guptar76/blueprints/(commit log)

2026-06-09 Initial Repo Structure commit
    [inv.sch, inv_tb.sch]
2026-06-12 Add 6T analog schematics
    [6T_sram_03v3.sch, 6t_sram_03v3_snm_tb.sch]
2026-06-13 SEEVINCK WORKED!!! ~Kinda
    [6T_sram_03v3.sch, 6t_sram_03v3_seevinck_calc.sch, 6t_sram_03v3_snm_tb.sch]
2026-06-13 Remove all previous files
    [6T_sram_03v3.sch, 6t_sram_03v3_seevinck_calc.sch, 6t_sram_03v3_snm_tb.sch, inv.sch, inv_tb.sch]
2026-06-13 Restore 6T_SRAM schematic
    [6t_sram_03v3.sch]
2026-06-13 Restore 6T_SRAM tests
    [6t_sram_03v3_hold_seevinck_tb.sch, 6t_sram_03v3_hold_snm_tb.sch]
2026-06-13 Add write, read tests for 6T SRAM
    [6t_sram_03v3_read_seevinck_tb.sch, 6t_sram_03v3_read_snm_tb.sch, 6t_sram_03v3_write_seevinck_tb.sch, 6t_sram_03v3_write_snm_tb.sch]
2026-06-14 Update 6T_sram_03v3_write_snm_tb.sch <!-- Not part of restore --> [skip ci]
    [6t_sram_03v3_write_snm_tb.sch]
2026-06-14 Fix file name from 6t_sram_03v3_write_snm_tb to 6t_sram_03v3_write_margin_tb.sch [skip ci]
    [6t_sram_03v3_write_margin_tb.sch]
2026-06-15 Add analog design for 6T bitcell [skip ci]
    [6t_sram_03v3.sch, 6t_sram_03v3_hold_seevinck_tb.sch, 6t_sram_03v3_hold_snm_tb.sch, 6t_sram_03v3_read_seevinck_tb.sch, 6t_sram_03v3_read_snm_tb.sch, 6t_sram_03v3_write_margin_tb.sch, 6t_sram_03v3_write_seevinck_tb.sch]
2026-06-19 Add updated 6T_03v3.sch & 6T_03v3.sym
    [6T_03v3.sch]
2026-06-19 Add 8T_03v3 initial schematic
    [8T_03v3.sch]
2026-06-19 Update 6T_3v3.sch to fix bug in transistor sizing $ W/L => L/W for AX transistors) $ [skip ci]
    [6T_03v3.sch]
2026-06-20 Add 6T_tb.sch 6T_open.sch [skip ci]
    [6T_open_tb.sch, 6T_tb.sch]
2026-06-20 Modify 8T_03v3.sch to include params_*.spice
    [8T_03v3.sch]
2026-06-20 Add 8T_03v3.sch & 8T_03v3.sym
    [8T_03v3.sch]
2026-06-20 Add 8T_tb.sch & 8T_tb.spice [skip ci]
    [8T_tb.sch]
2026-06-20 Fix incorrect & incomplete .include params.spice to .include params_6T.spice && .include params_8T.spice
    [8T_tb.sch]
2026-06-20 Add 8T_open_tb.sch & 8T_open_tb.spice [skip ci]
    [8T_open_tb.sch]
2026-06-20 Fix pin label names to match input ports
    [8T_tb.sch]
2026-06-20 Fix pin labels for 8T_tb
    [8T_tb.sch]
2026-06-20 Fix pin misalignment for 8T_open_tb.spice
2026-06-20 Fix pin alignments for 8t and 6t cells
    [6T_tb.sch, 8T_03v3.sch, 8T_tb.sch]
2026-06-21 Update 8T_03v3.sch and 6T_03v3.sch : remove .lib <path>
    [6T_03v3.sch, 8T_03v3.sch]
2026-06-24 Update 8T_03v3.*: Keep only param_*.spice .include
    [8T_03v3.sch]
2026-06-24 Fix .include conflict in 8T_open_tb.* && 8T_tb.*
    [8T_open_tb.sch, 8T_tb.sch]
2026-06-29 Fix shift_reg.sv: incorrect shifting logic
    [shift_reg.sv]
2026-06-30 Add EOF newline: %Error flagged by verilator
    [act_shift_chain.sv, dcim_array.sv, dcim_pkg.sv]
2026-06-30 Fix col_adder: Incorrect $clog2() logic
    [col_adder.sv]
2026-07-12 Fix WidthTrunc warning in col_adder.sv
    [col_adder.sv]
2026-07-12 Update col_adder.sv: Fix module & file name mismatch
    [adder_tree.sv, col_adder.sv]
2026-07-12 Fix WIDTHEXPAND Warnings in control_fsm.sv
    [control_fsm.sv]
2026-07-12 Fix all WIDTHEXPAND or WIDTHTRUNC warnings
    [dcim_top.sv, lane_shift_accum.sv, shift_accum.sv, stream_out.sv, weight_load.sv]
2026-07-12 fix stream_out.sv 2D -> 1D: added cast
    [stream_out.sv]
2026-07-14 Update pvt_sweep.ipynb: Ful flow complete PVT corners pass
2026-07-14 Update .gitignore: Ignore analog/flow/results folder
2026-07-14 Fix hold_snm.spice: Missing parameterized VDD for q rail
2026-07-14 Rename folder tests -> tb
    [6T_open_tb.sch, 6T_tb.sch, 8T_open_tb.sch, 8T_tb.sch]
2026-07-16 Add col_64 analog/designs
    [col_64.sch, col_64_tb.sch]
2026-07-16 Fix 8T_03v3 cell for 2T multiplication
    [8T_03v3.sch]
2026-07-16 Update 8T tb for new 8T_03v3 design
    [8T_open_tb.sch, 8T_tb.sch]
2026-07-18 Update mult_w1a0_test.spice: Add crowbar current analysis
2026-07-18 Fix row_decoder paramater naming
    [dcim_array.sv, row_decoder.sv]
2026-07-20 Update control_fsm.sv: Fix row_cnt defaulting to zero
    [control_fsm.sv]
2026-07-20 Update control_fsm.sv: Re-fix row_cnt when !wfull && update y_en logic to resemble change in stream_out.sv conditional statements
    [control_fsm.sv]
2026-07-28 Update control_fsm.sv: Fix Icarus-verilog elaboration error
    Remove ternary and use conditional statements.
    Note: Icarus doesn't seem to support automatic logic detection on user-defined datatypes with the ternary operator.
    [control_fsm.sv]
2026-08-05 Add 9T_03v3 schematic
    [9T_03v3.sch]
2026-08-05 Fix control_fsm for icarus lint
    [control_fsm.sv]
2026-08-07 Update sizing of 9T_03v3 bitcell
    [9T_03v3.sch]
2026-08-07 Update 9T_03v3.sch file
    [9T_03v3.sch]
2026-08-08 Add multiple 9T_* files & sram_8x8_9T (the name of the file will change as per the configuration)
    [8T_03v3.sch]
2026-08-10 Add VDD and VSS rail ports
2026-08-12 First working run: DRC errors persist
    [config.yaml, dcim_array.sv, dcim_pkg.sv, sram_32x8_9T.v, sram_32x8_9T_blackbox.v, sram_32x8_9T_blackbox_pp.v]
2026-08-13 DRC & LVS clean
    [6T_03v3.sch]
2026-08-14 Remove 6t simulations
    [6T_open_tb.sch, 6T_tb.sch]
2026-08-17 Add core-only librelane flow: DRC clean.
2026-08-17 Fix Netgen LVS & STA Warnings: DRC & LVS Clean.
    [config_core.yaml]
2026-08-17 Add pdn_core_cfg.tcl: Fix core target
    [config_core.yaml]
2026-08-19 Update flow config to stream & and change chip_core to dcim_top
2026-08-20 Add reports/* documents
    [metrics.csv]
2026-08-20 Update control_fsm.sv: wshift_en was unconditionally driven / wrong
    [control_fsm.sv]
2026-08-20 Add io_pin_order.cfg
    [io_pin_order.cfg]
2026-08-20 Add violation fixes to config_core.yaml
    [config_core.yaml]
2026-08-21 Rename power and gnd pins to uppercase
2026-08-21 Update config_core.yaml: Remove line to skip Checker.PowerGridViolations
    [config_core.yaml]
2026-08-21 Update io_pin_order.cfg: Set pins to West
    [io_pin_order.cfg]
2026-08-22 Add def folder
    [A07_A_padring.cfg]
2026-08-22 Add A07_dcim_top wrapper as top cell & Update all pin definitions
2026-08-24 Update src/*.sv files: Fix lint warnings (`timescale)
    [A07_A_padring.cfg]
2026-08-24 Update sram_32x8_9T.v: Fix make lint warning
    [sram_32x8_9T.v]
2026-08-26 Add Cleanup changes
    [8T_03v3.sch, 8T_open_tb.sch, 8T_tb.sch, 9T_03v3.sch]
2026-08-26 Update reports/ folder to add raw files
    [metrics.csv]
2026-08-29 Add full chip flow along && Update sram_32x8_9T to have PR_BNDRY (0/0) layer
2026-09-02 Update gds file: Connect all fingers of VDD and VSS connections
